alexandru-mot/SAVITAR-V2-PCB/models/gearmotor_module_assembly_inline_rev3_mirror.step

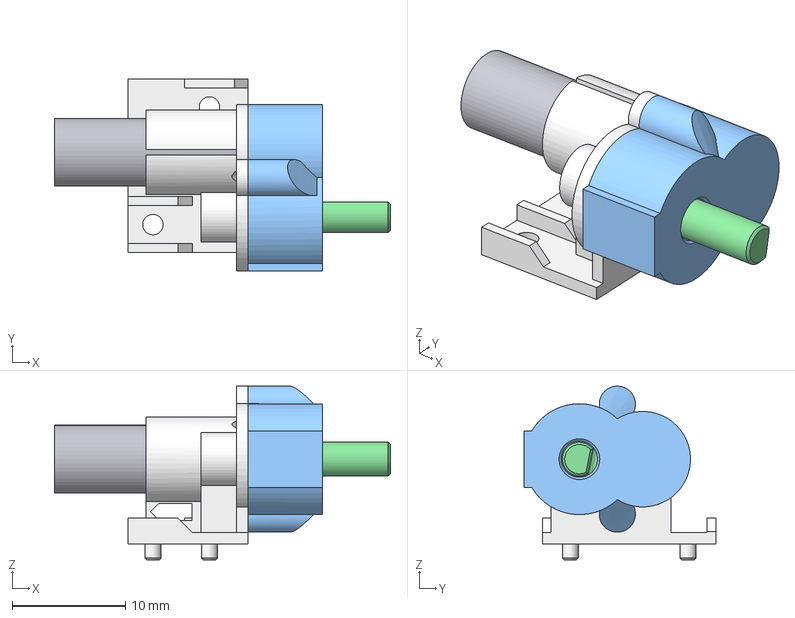
[picture p1: CAD file, 2026-11-13]
models/gearmotor_module_assembly_inline_rev3_mirror.step
29.7 x 17.0 x 15.4 mm
housing_base
housing_cover
motor
pinion_12T
gear_16T
