alexandru-mot/SAVITAR-V2-PCB/sensor.step

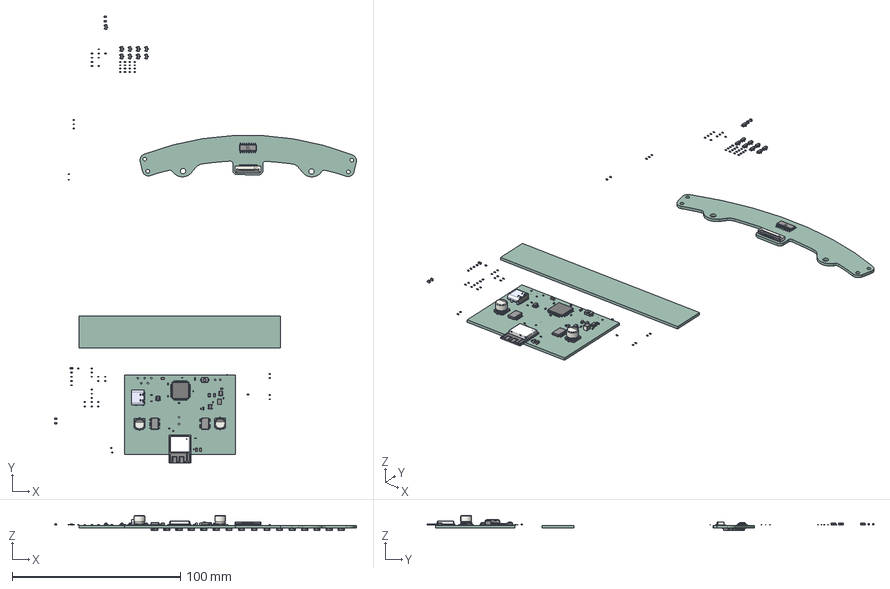
[picture p2: CAD file, 2026-10-30]
sensor.step
179.7 x 265.7 x 8.93 mm
R_0402_1005Metric x 54
LED_0603_1608Metric x 4
C_0402_1005Metric x 19
SOT-23 x 9
C_0603_1608Metric x 3
SOT-23-5
SW_SPST_TS-1088-xR020
C_0805_2012Metric x 4
SOT-23-6
TQFP-64_10x10mm_P0.5mm
FPC-SMD_22P-P0.50_FPC-05F-22PH20
CP_Elec_6.3x5.8 x 2
ESP32-C3-MINI-1-N4
TYPE-C-31-M-12
PinsArrayLR x 3
LED_0805_2012Metric
L_1210_3225Metric
SOT109-1 lower body
SOT109-1 upper body
SOT109-1 Lead
L_0603_1608Metric
OnSemi_CASE100CY x 16
SAVITAR_V2_PCB_1
SAVITAR_V2_PCB_2
SAVITAR_V2_PCB_3
