alexandru-mot/SAVITAR-V2-PCB/models/JS2622.stp

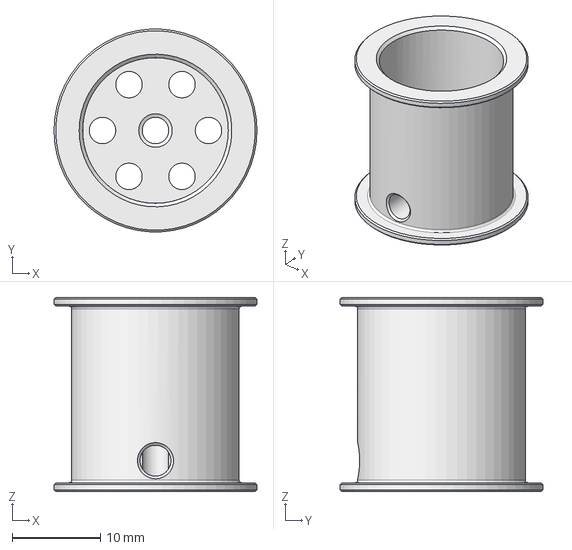
[picture p3: CAD file, 2026-11-13]
models/JS2622.stp
23.0 x 23.0 x 22.0 mm
