alexandru-mot/SAVITAR-V2-PCB/models/Roata_JS2622.stp

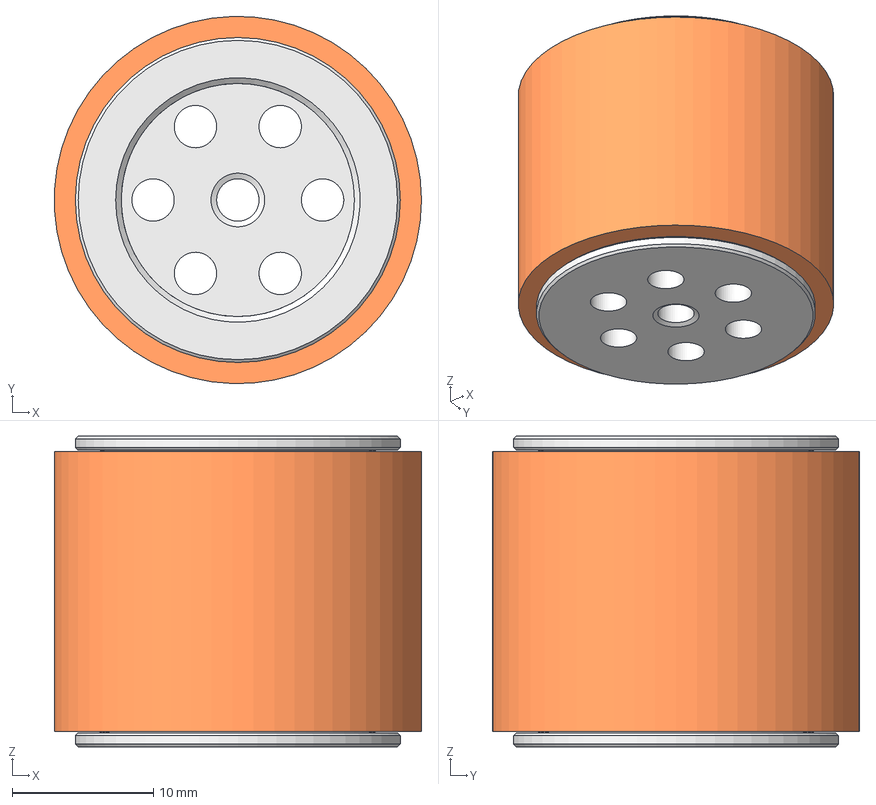
[picture p4: CAD file, 2026-11-13]
models/Roata_JS2622.stp
26.0 x 26.0 x 22.0 mm
JS2622
Goma JS2622
