alexandru-mot/SAVITAR-V2-PCB/models/FSUSB42MUX.stp

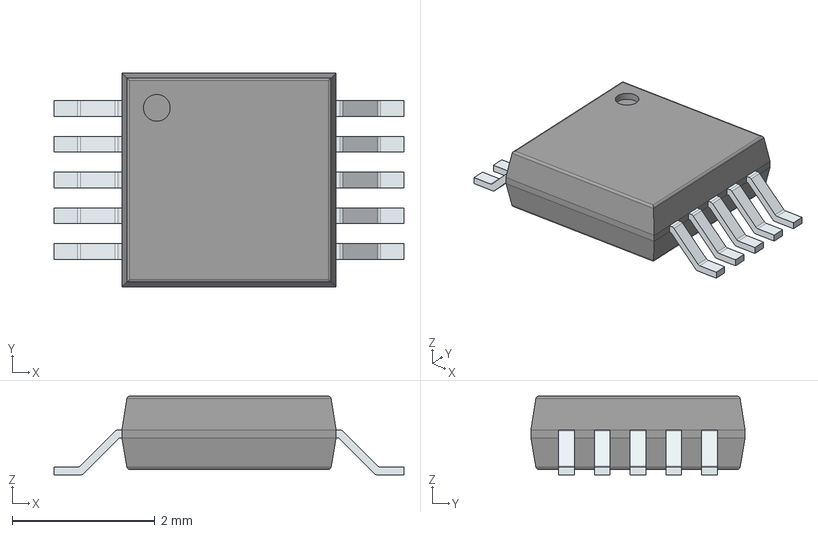
[picture p5: CAD file, 2026-05-28]
models/FSUSB42MUX.stp
4.90 x 3.00 x 1.10 mm
PinsArrayLR
