alexandru-mot/SAVITAR-V2-PCB/models/SSSS811101.step

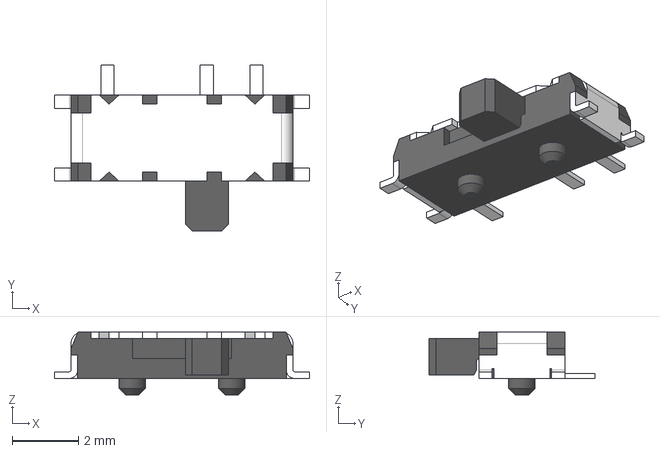
[picture p6: CAD file, 2026-05-28]
models/SSSS811101.step
7.70 x 5.00 x 1.90 mm
