alexandru-mot/SAVITAR-V2-PCB/models/TYPE-C-31-M-12.step

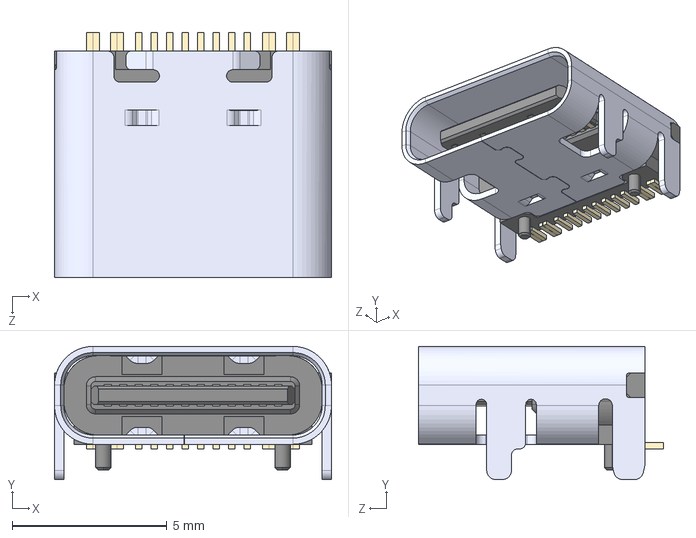
[picture p7: CAD file, 2026-05-28]
models/TYPE-C-31-M-12.step
8.94 x 4.30 x 7.90 mm
