alexandru-mot/SAVITAR-V2-PCB/models/FH34SRJ-8S-0.5SH_50_.step

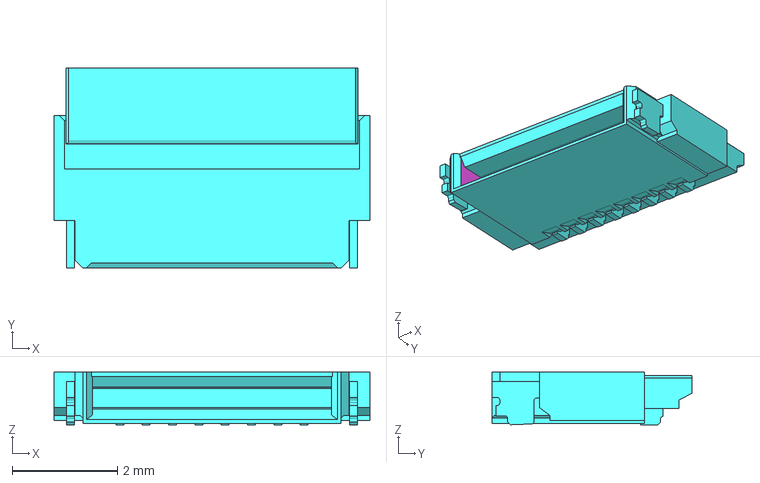
[picture p8: CAD file, 2026-05-23]
models/FH34SRJ-8S-0.5SH_50_.step
6.00 x 3.80 x 1.00 mm
