alexandru-mot/SAVITAR-V2-PCB/models/ESP32-C3-MINI-1-N4.stp

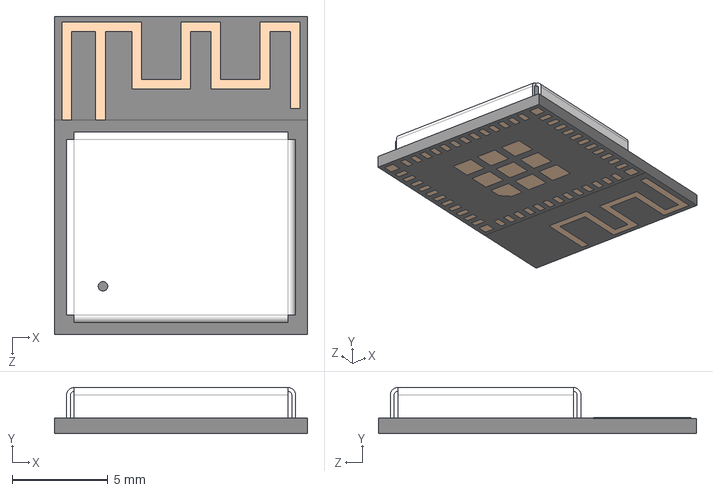
[picture p9: CAD file, 2026-05-23]
models/ESP32-C3-MINI-1-N4.stp
13.2 x 2.40 x 16.6 mm
