alexandru-mot/SAVITAR-V2-PCB/models/INA240A1DR.stp

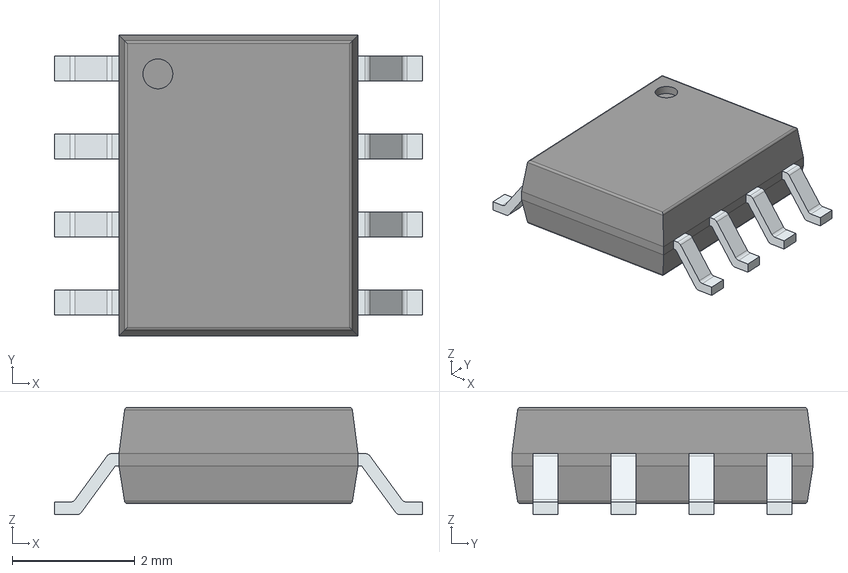
[picture p10: CAD file, 2026-05-20]
models/INA240A1DR.stp
6.00 x 4.91 x 1.75 mm
PinsArrayLR
