alexandru-mot/SAVITAR-V2-PCB/models/DRV8874PWPR.stp

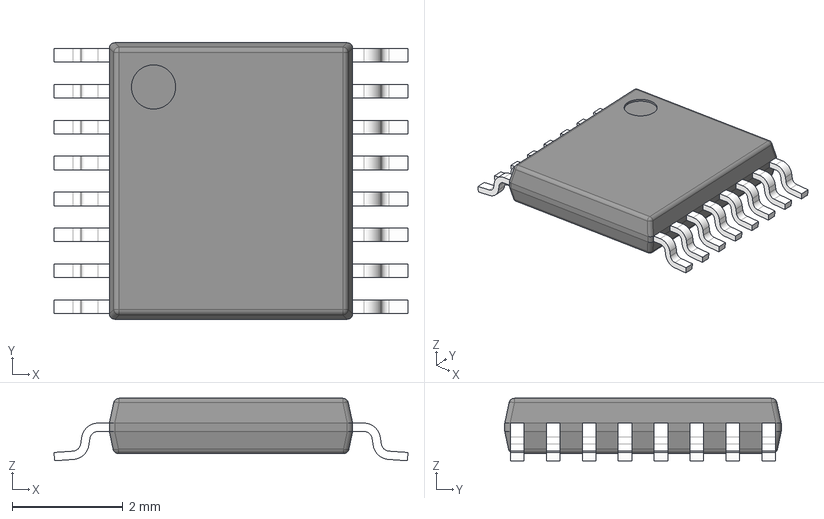
[picture p11: CAD file, 2026-05-17]
models/DRV8874PWPR.stp
6.40 x 5.00 x 1.13 mm
BODY-TSSOP
LEAD-TSSOP x 16
PIN1
DAP
