alexandru-mot/SAVITAR-V2-PCB/models/DEV-15583.step

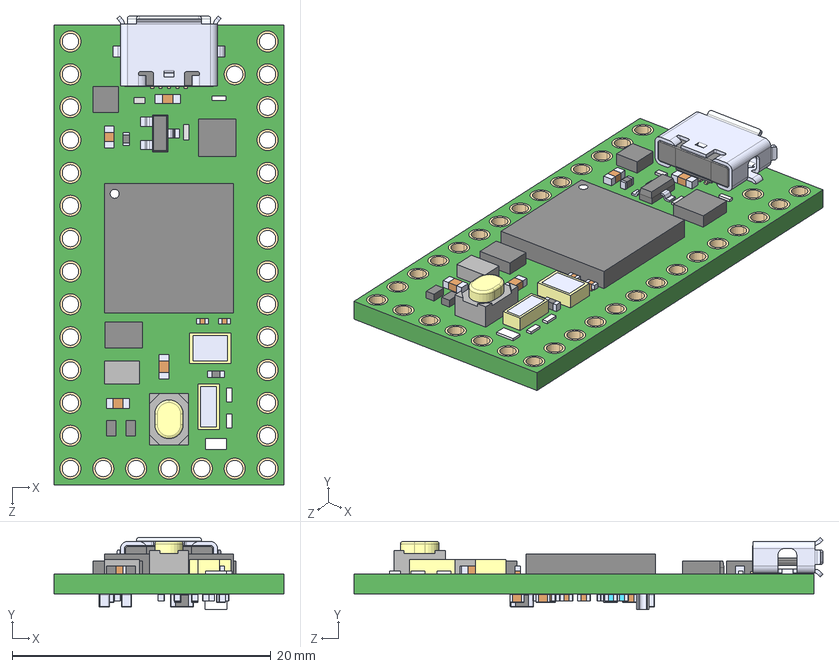
[picture p12: CAD file, 2026-05-17]
models/DEV-15583.step
17.8 x 5.58 x 36.3 mm
DEV-15583 board
C5-C18 (0.55mm)
C20-C24 (0.65)
R1-R3 (0.4inch)_1269AS-H-3R3M=P2
L1^DEV-15583 ASS
C x 2
C2
