alexandru-mot/SAVITAR-V2-PCB/models/MT2492.stp

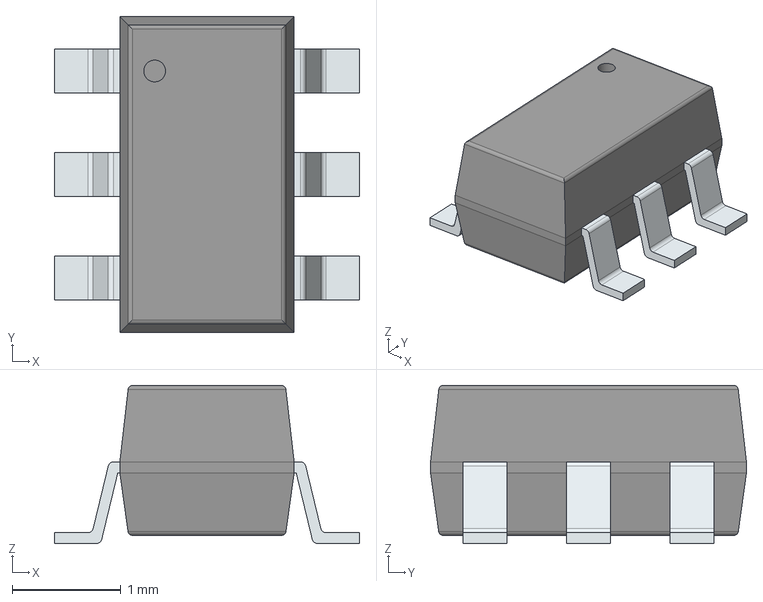
[picture p13: CAD file, 2026-05-14]
models/MT2492.stp
2.80 x 2.90 x 1.45 mm
PinsArrayLR
