alexandru-mot/SAVITAR-V2-PCB/models/74HC238D,653.stp

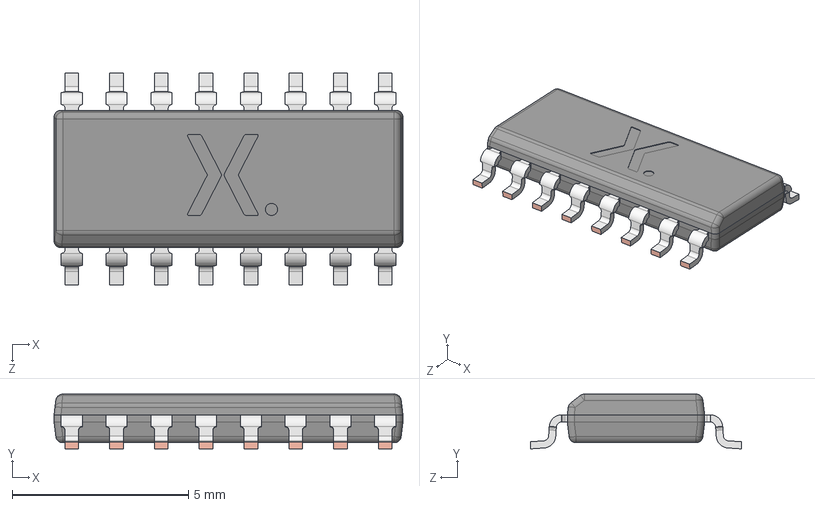
[picture p14: CAD file, 2026-05-12]
models/74HC238D,653.stp
9.90 x 1.56 x 6.00 mm
SOT109-1 lower body
SOT109-1 upper body
SOT109-1 Lead
