alexandru-mot/SAVITAR-V2-PCB/models/CD4051BM_TR.stp

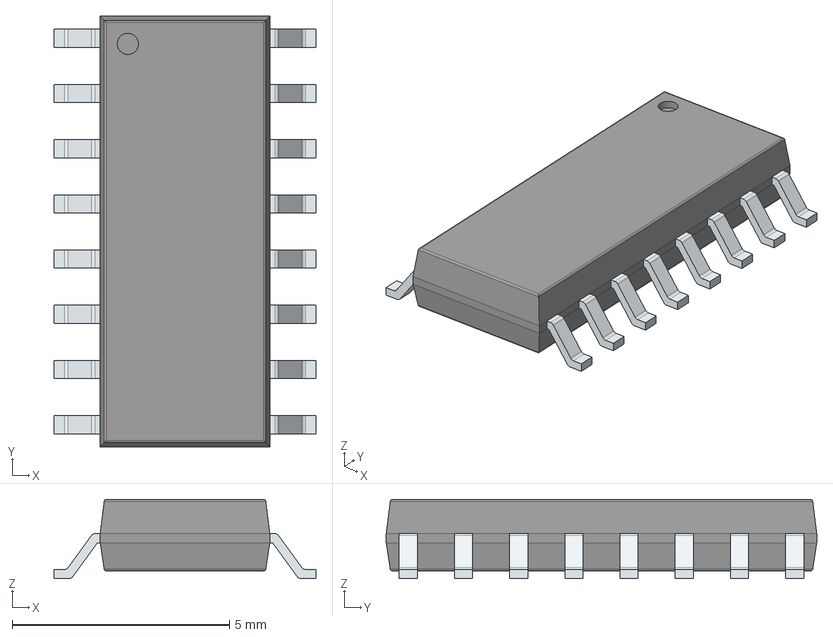
[picture p15: CAD file, 2026-05-10]
models/CD4051BM_TR.stp
6.03 x 9.90 x 1.82 mm
PinsArrayLR
