alexandru-mot/SAVITAR-V2-PCB/models/FH34SRJ-12S-0.5SH_50_.stp

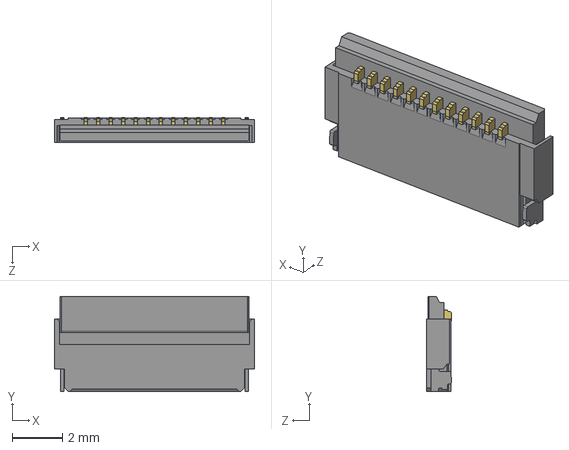
[picture p16: CAD file, 2026-05-10]
models/FH34SRJ-12S-0.5SH_50_.stp
8.00 x 3.80 x 1.00 mm
