alexandru-mot/SAVITAR-V2-PCB/(list of files, cad)

Other CAD files:
models/gearmotor_module_assembly_inline_rev3.step
models/FH34SRJ-8S-0.5SH_99_.stp
models/ESP32-C3-MINI-1-H4X.stp
models/52271-0869.stp
models/FH34SRJ-8S-0.5SH_50_.stp
models/TBD62083AFNG_Z,EL_.stp
models/gearmotor_module_assembly_inline_rev2.step
models/gearmotor_module_assembly_inline_rev2_mirror.step
