alexandru-mot/SAVITAR-V2-PCB/SAVITAR_V2-SAMD51 ESP32.pdf

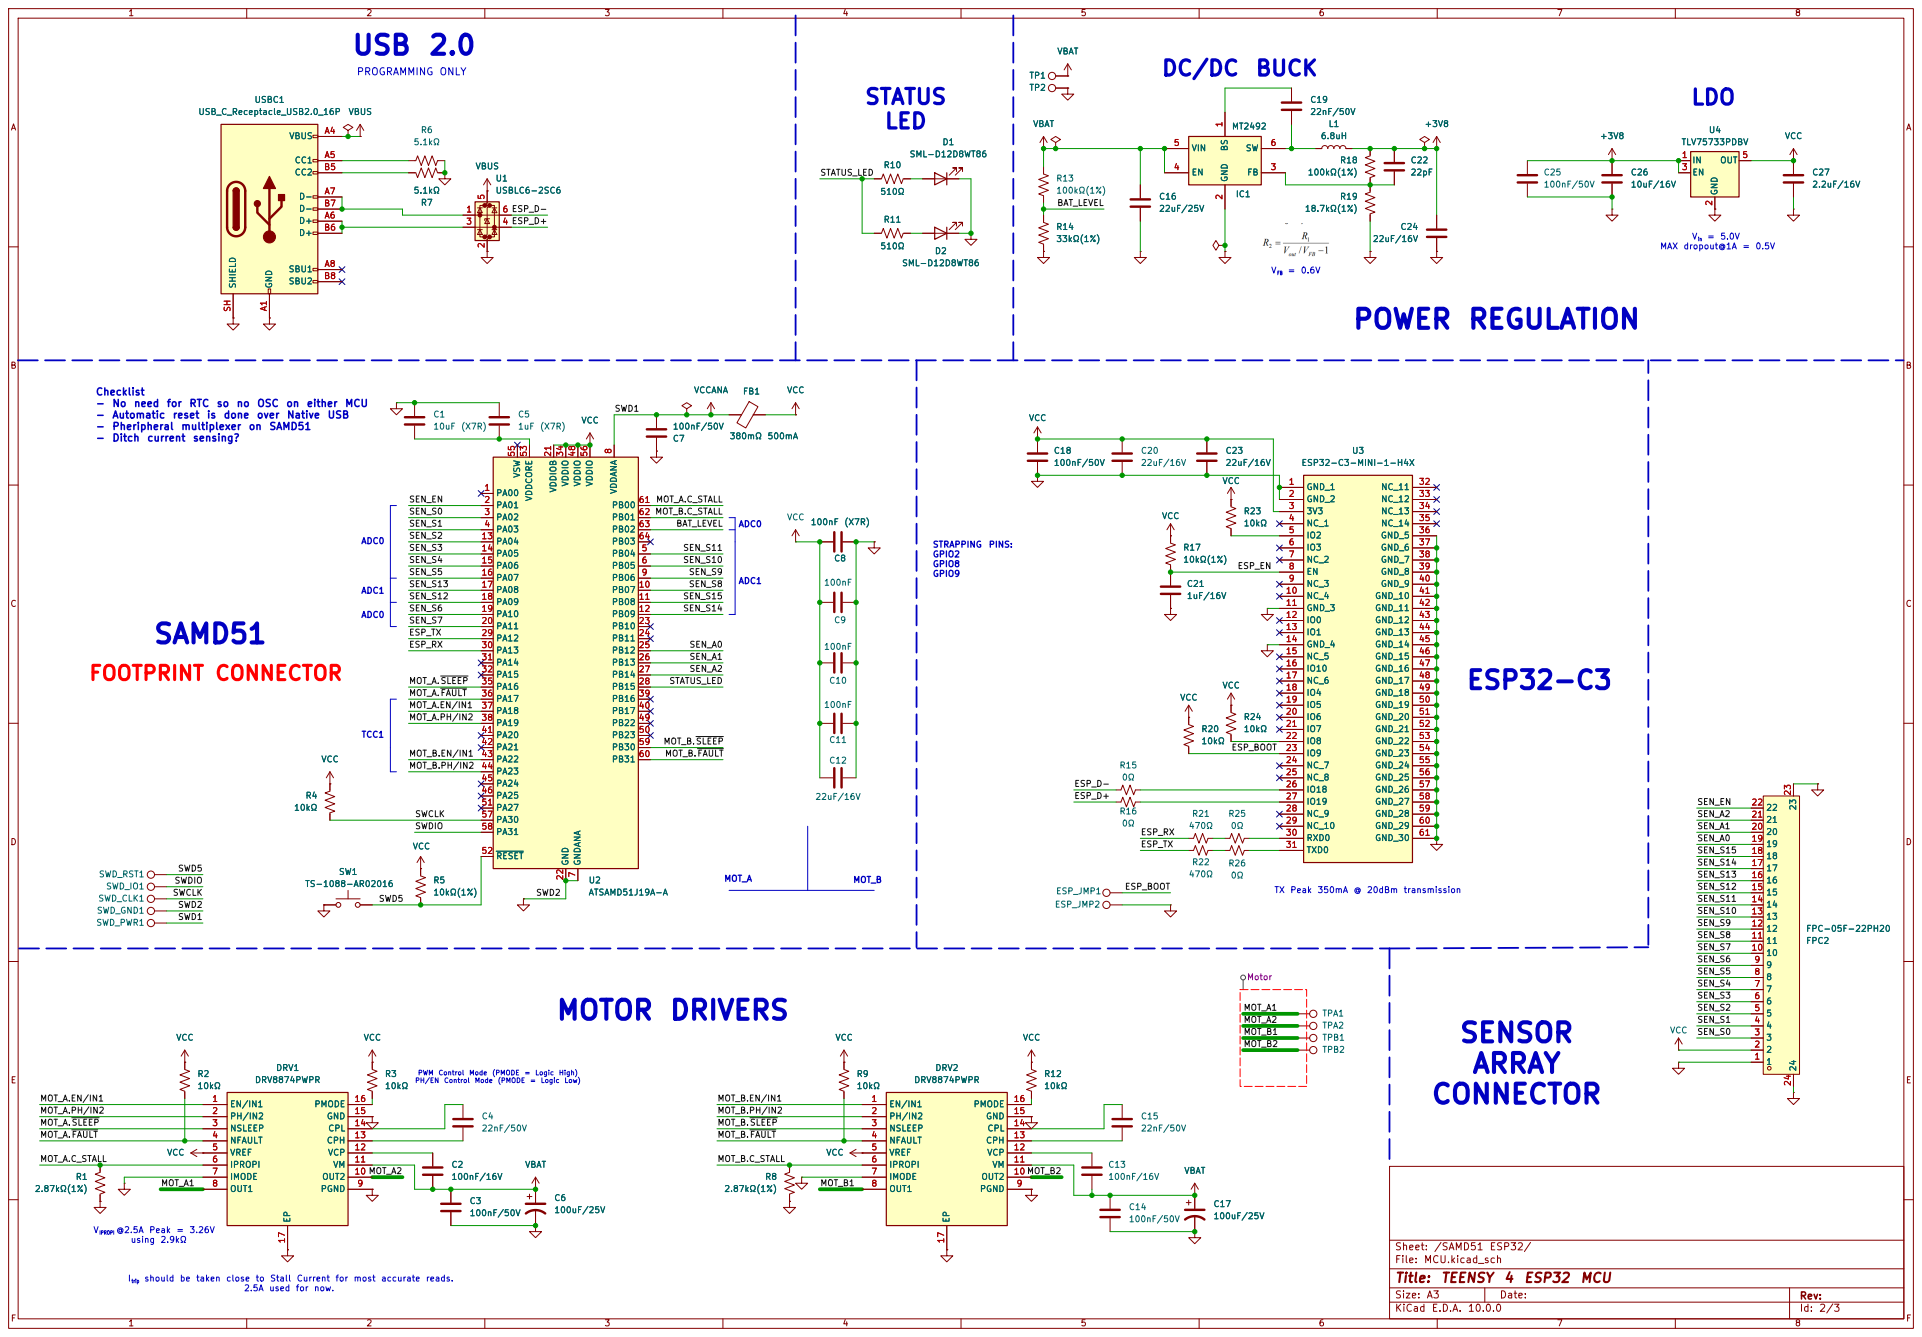
[picture p17: page 1]

V FB = 0.6V Checklist - No need for RTC so no OSC on either MCU - Automatic reset is done over Native USB - Pheripheral multiplexer on SAMD51 - Ditch current sensing?

I trip should be taken close to Stall Current for most accurate reads. 2.5A used for now. FOOTPRINT CONNECTOR

Size: A3 | Rev: | F Date:
KiCad E.D.A. 10.0.0 | Id: 2/3
