alexandru-mot/SAVITAR-V2-PCB/SAVITAR_V2.pdf

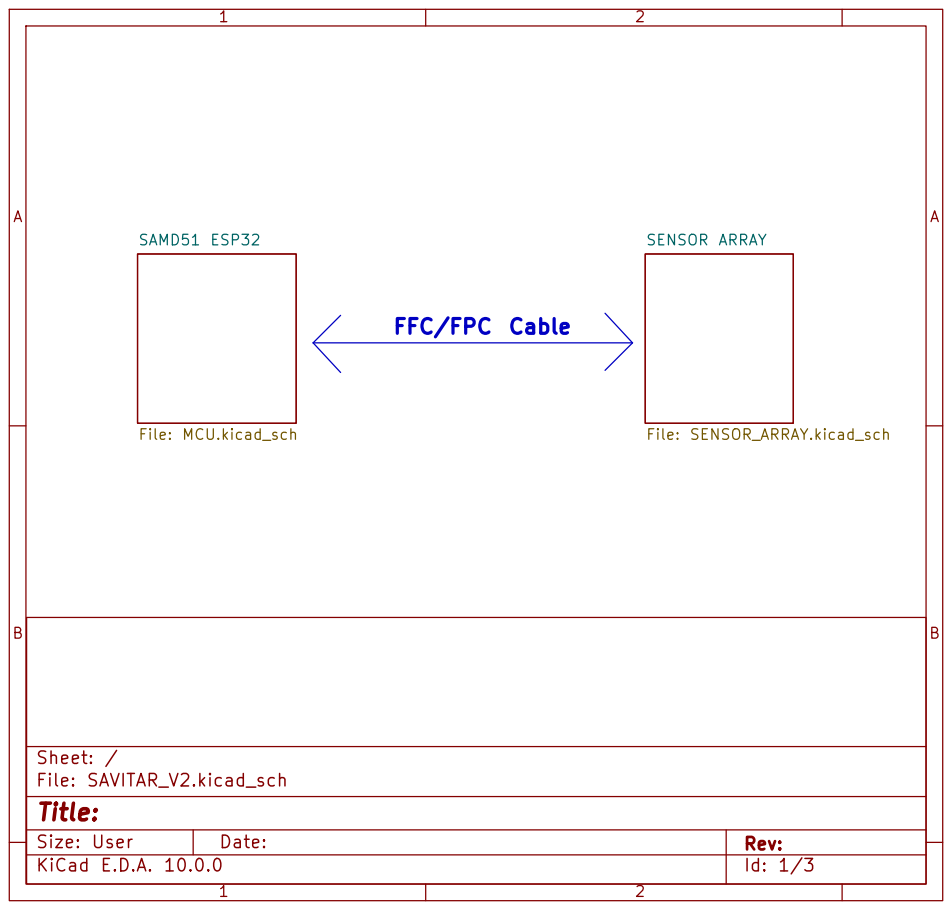
[picture p18: page 1]

File: SENSOR_ARRAY.kicad_sch FFC/FPC Cable

Size: User | Rev:
KiCad E.D.A. 10.0.0 | Id: 1/3

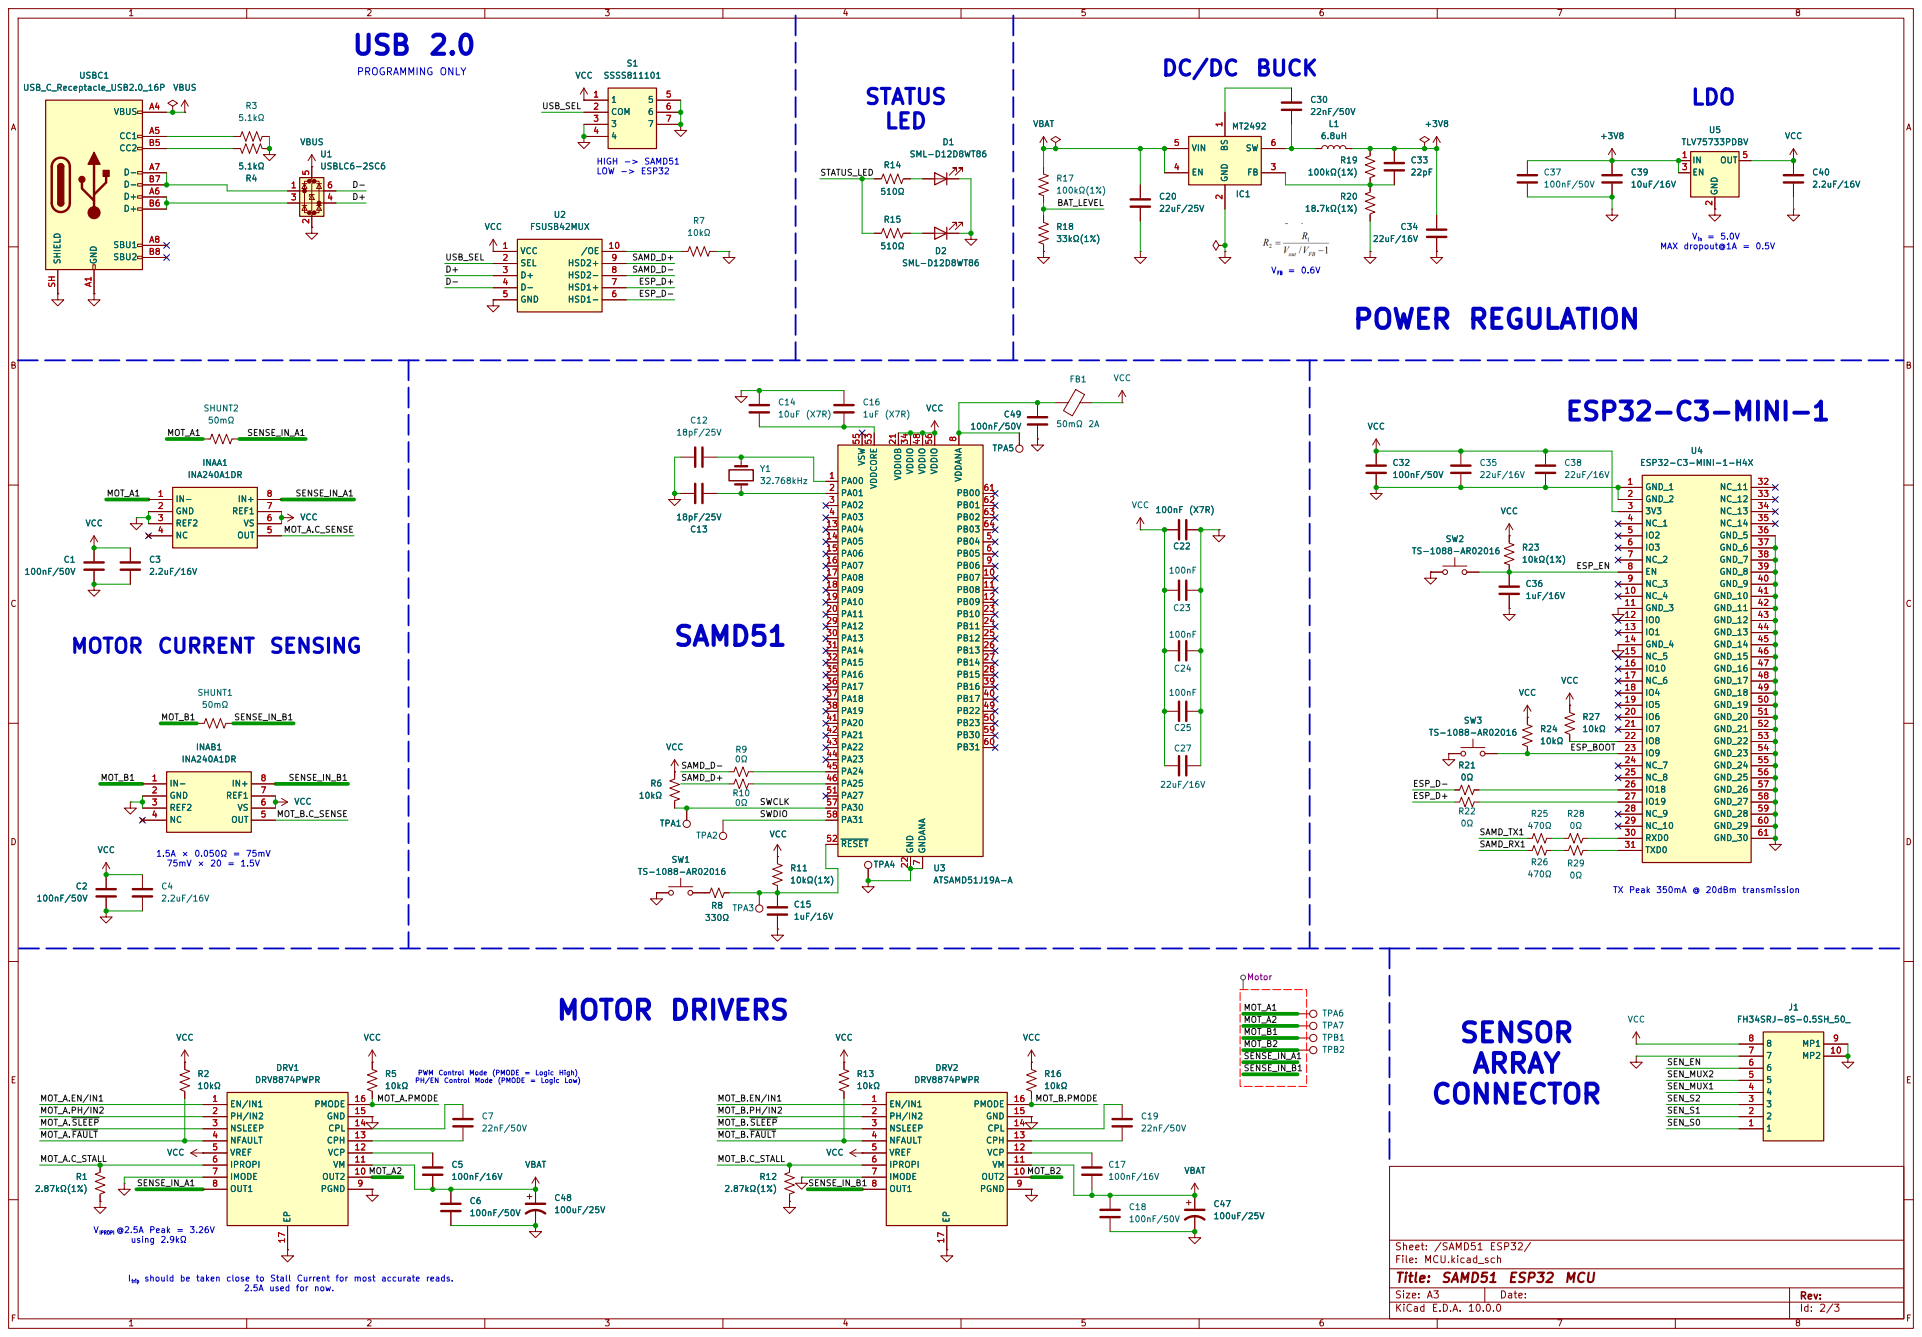
[picture p19: page 2]

PROGRAMMING ONLY MOTOR CURRENT SENSING

IO3 6 NC_2 7 | 37 GND_7
EN 8 NC_3 9 NC_4 10 GND_3 11 | 38 GND_8 38 GND_8 39 GND_9 39 GND_9

IO0 12 | 43 GND_13
IO1 13 GND_4 14 NC_5 15 | 45 GND_15

IO10 16 NC_6 17 | 47 GND_17

IO4 18 | 49 GND_19
IO5 19 | 50 GND_20
IO6 20 | 51 GND_21

IO9 23 NC_7 24 NC_8 25 | 55 GND_25

IO18 26 IO18 26 IO19 27 NC_9 28 NC_10 29 RXD0 30 IO19 27 NC_9 28 NC_10 29 RXD0 30 | 57 GND_27

Size: A3 | Rev: | F Date:
KiCad E.D.A. 10.0.0 | Id: 2/3

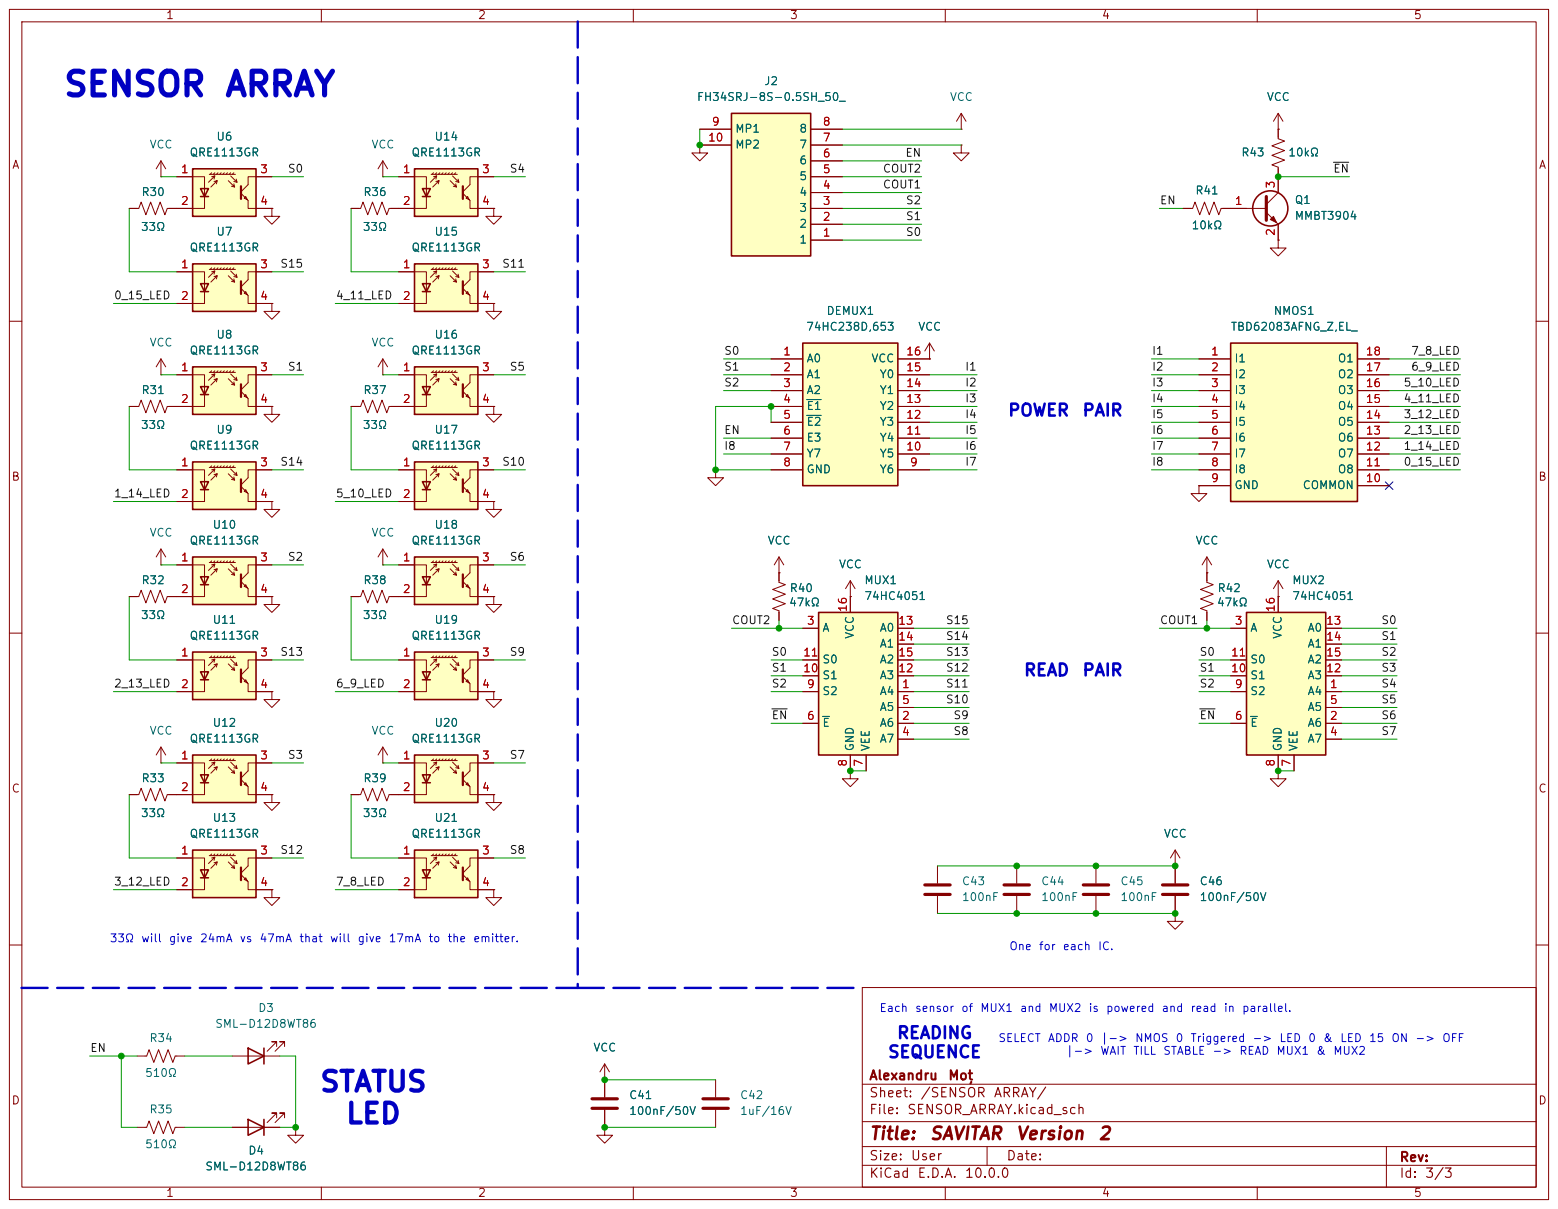
[picture p20: page 3]

33Ω will give 24mA vs 47mA that will give 17mA to the emitter. SENSOR ARRAY

One for each IC.

Each sensor of MUX1 and MUX2 is powered and read in parallel.
READING
SEQUENCE
Alexandru Moț
Sheet: /SENSOR ARRAY/
File: SENSOR_ARRAY.kicad_sch
Title: SAVITAR Version 2

SELECT ADDR 0 |-> NMOS 0 Triggered -> LED 0 & LED 15 ON -> OFF |-> WAIT TILL STABLE -> READ MUX1 & MUX2

Size: User | Rev:
KiCad E.D.A. 10.0.0 | Id: 3/3
