alexandru-mot/SAVITAR-V2-PCB/Output/SAVITAR_V2.pdf

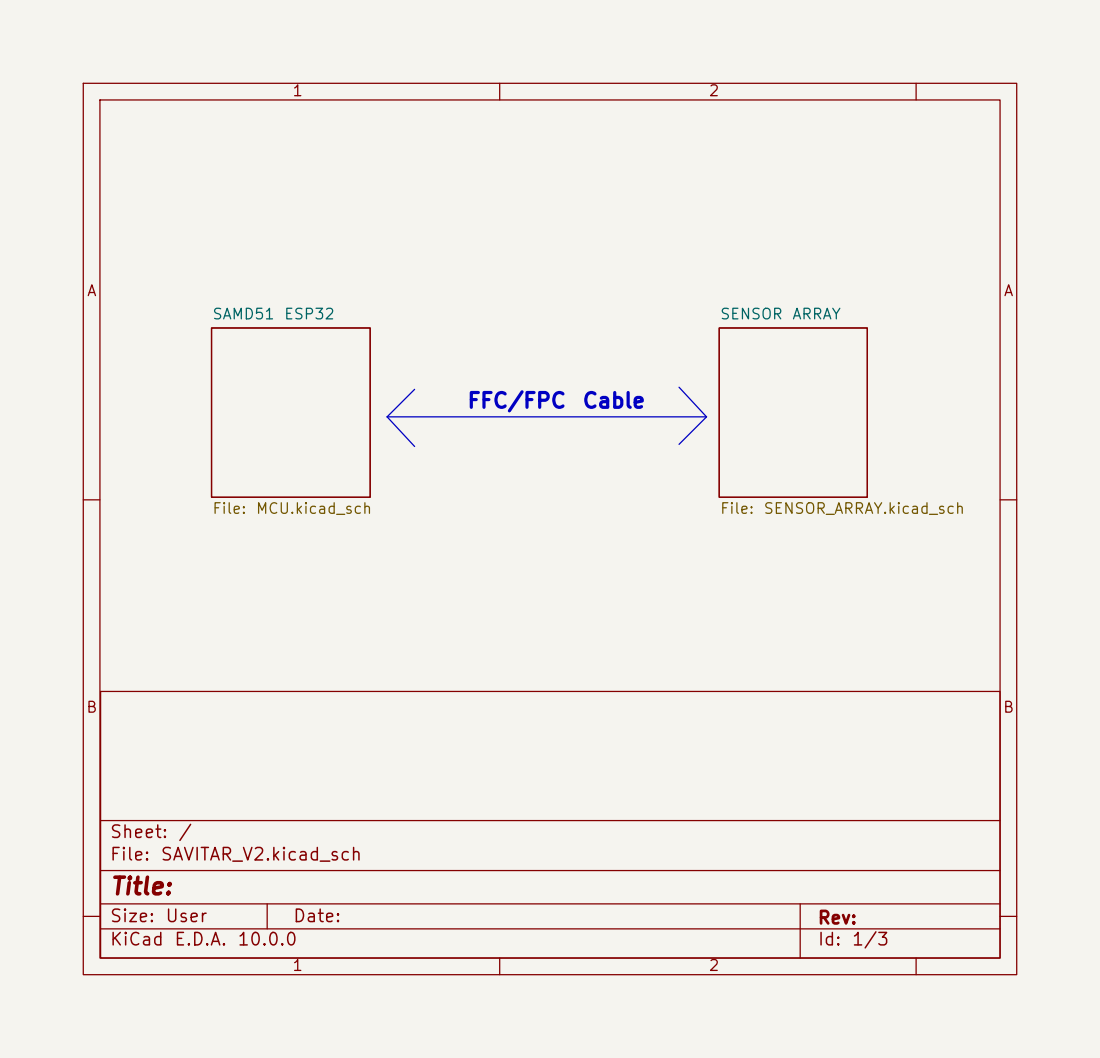
[picture p21: page 1]

File: SENSOR_ARRAY.kicad_sch FFC/FPC Cable

Size: User | Rev:
KiCad E.D.A. 10.0.0 | Id: 1/3

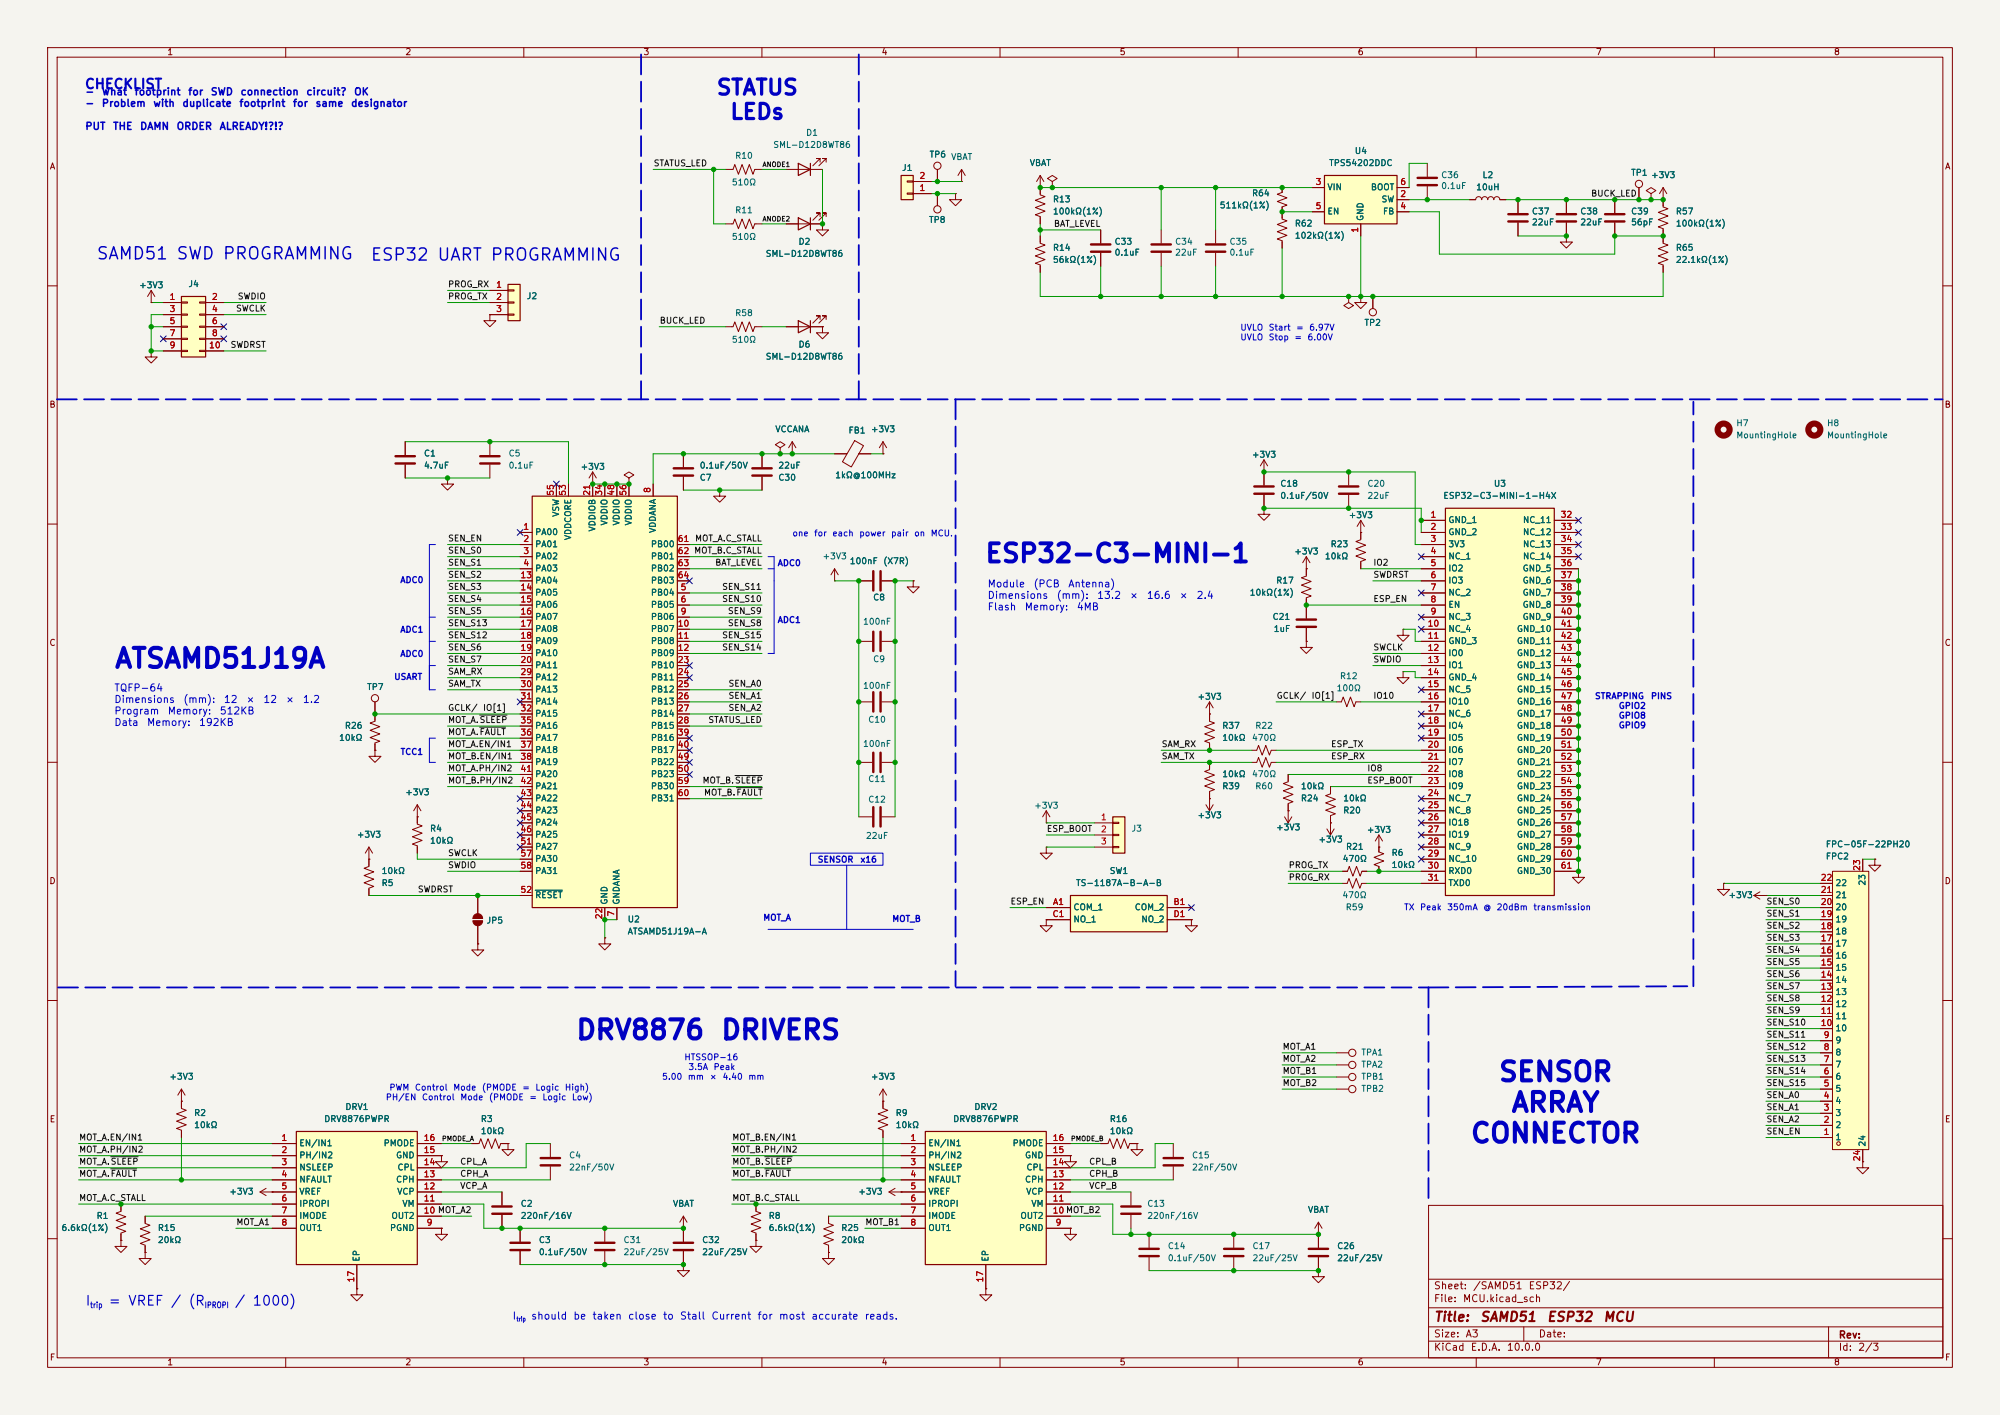
[picture p22: page 2]

PUT THE DAMN ORDER ALREADY!?!?

PROG_RX
PROG_TX
one for each power pair on MCU. MOT_B

UVLO Start = 6.97V UVLO Stop = 6.00V USART ATSAMD51J19A

TX Peak 350mA @ 20dBm transmission Module (PCB Antenna)
Dimensions (mm): 13.2 × 16.6 × 2.4
Flash Memory: 4MB

TQFP-64
Dimensions (mm): 12 × 12 × 1.2 Program Memory: 512KB

I trip should be taken close to Stall Current for most accurate reads. PWM Control Mode (PMODE = Logic High)
PH/EN Control Mode (PMODE = Logic Low)

Size: A3 | Rev: | F Date:
KiCad E.D.A. 10.0.0 | Id: 2/3

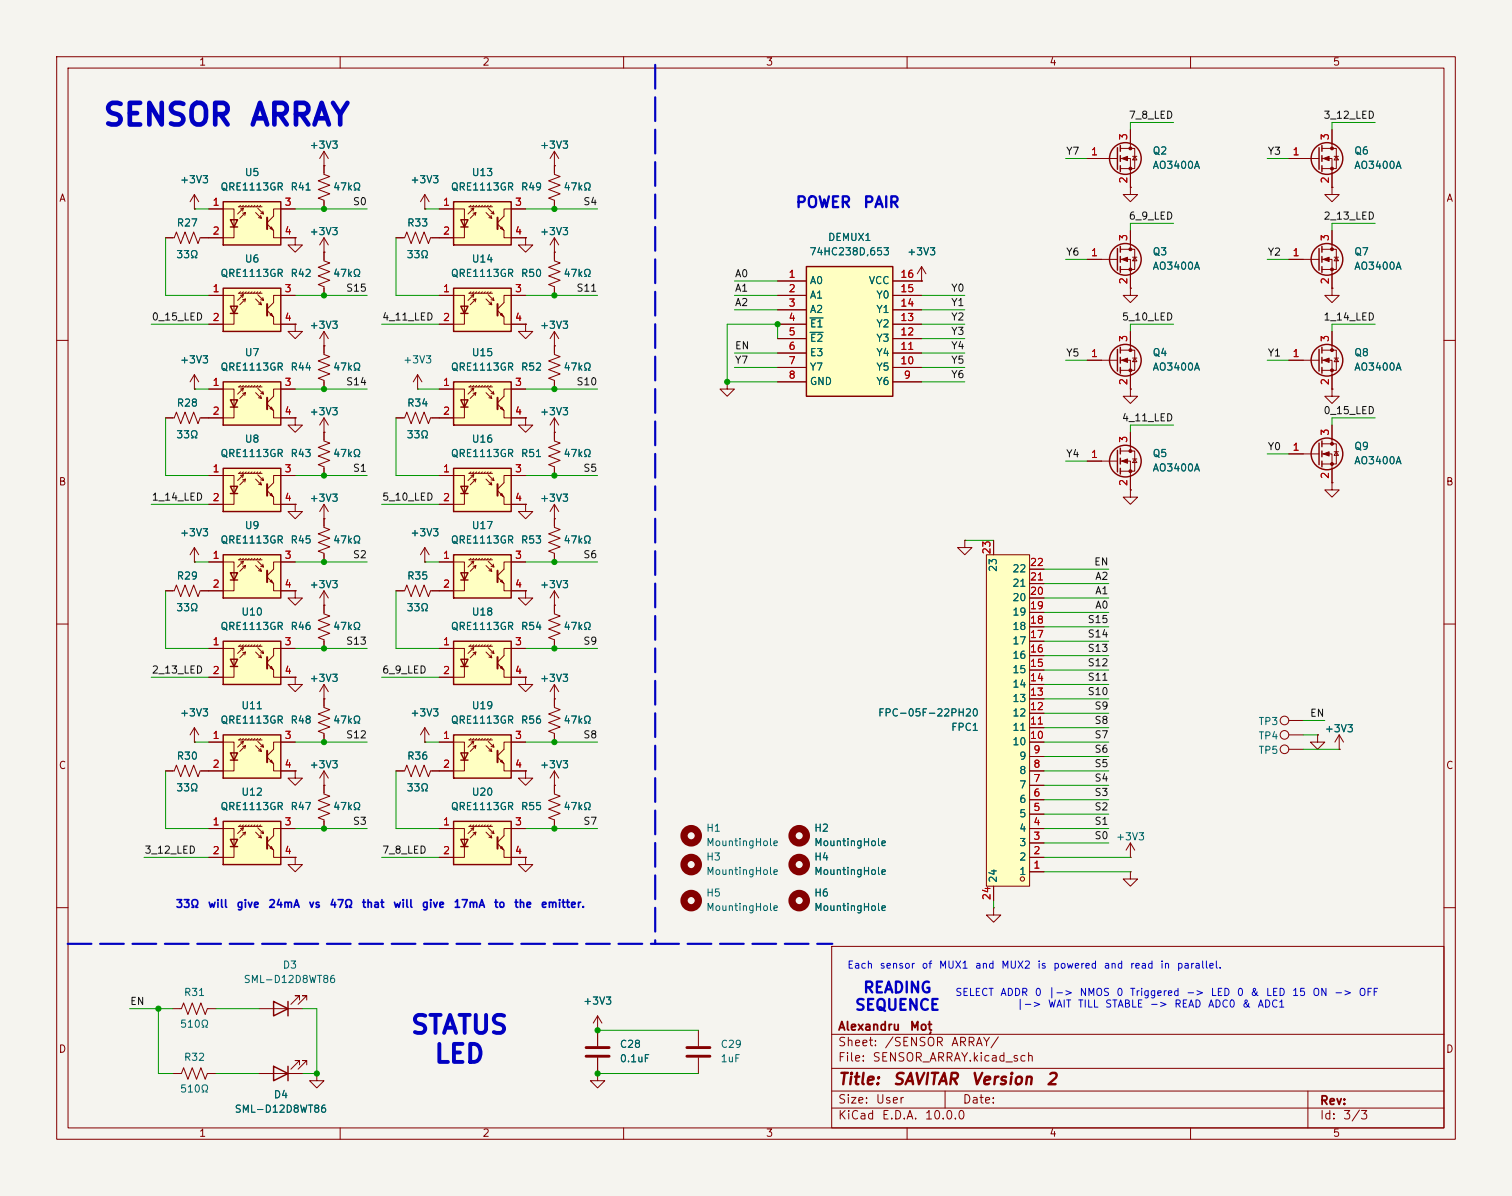
[picture p23: page 3]

Each sensor of MUX1 and MUX2 is powered and read in parallel.

SELECT ADDR 0 |-> NMOS 0 Triggered -> LED 0 & LED 15 ON -> OFF |-> WAIT TILL STABLE -> READ ADC0 & ADC1 READING
SEQUENCE

Size: User | Rev:
KiCad E.D.A. 10.0.0 | Id: 3/3
