alexandru-mot/SAVITAR-V2-PCB/SAVITAR_V2.kicad_pcb

## KiCad design SAVITAR_V2.kicad_pcb (2026-11-13)

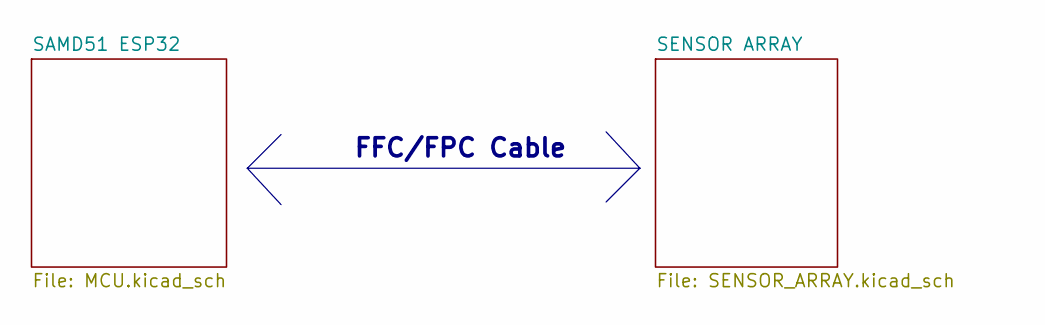
[picture p24: schematic SAVITAR_V2.kicad_sch]

Notes on the sheet:
FFC/FPC Cable

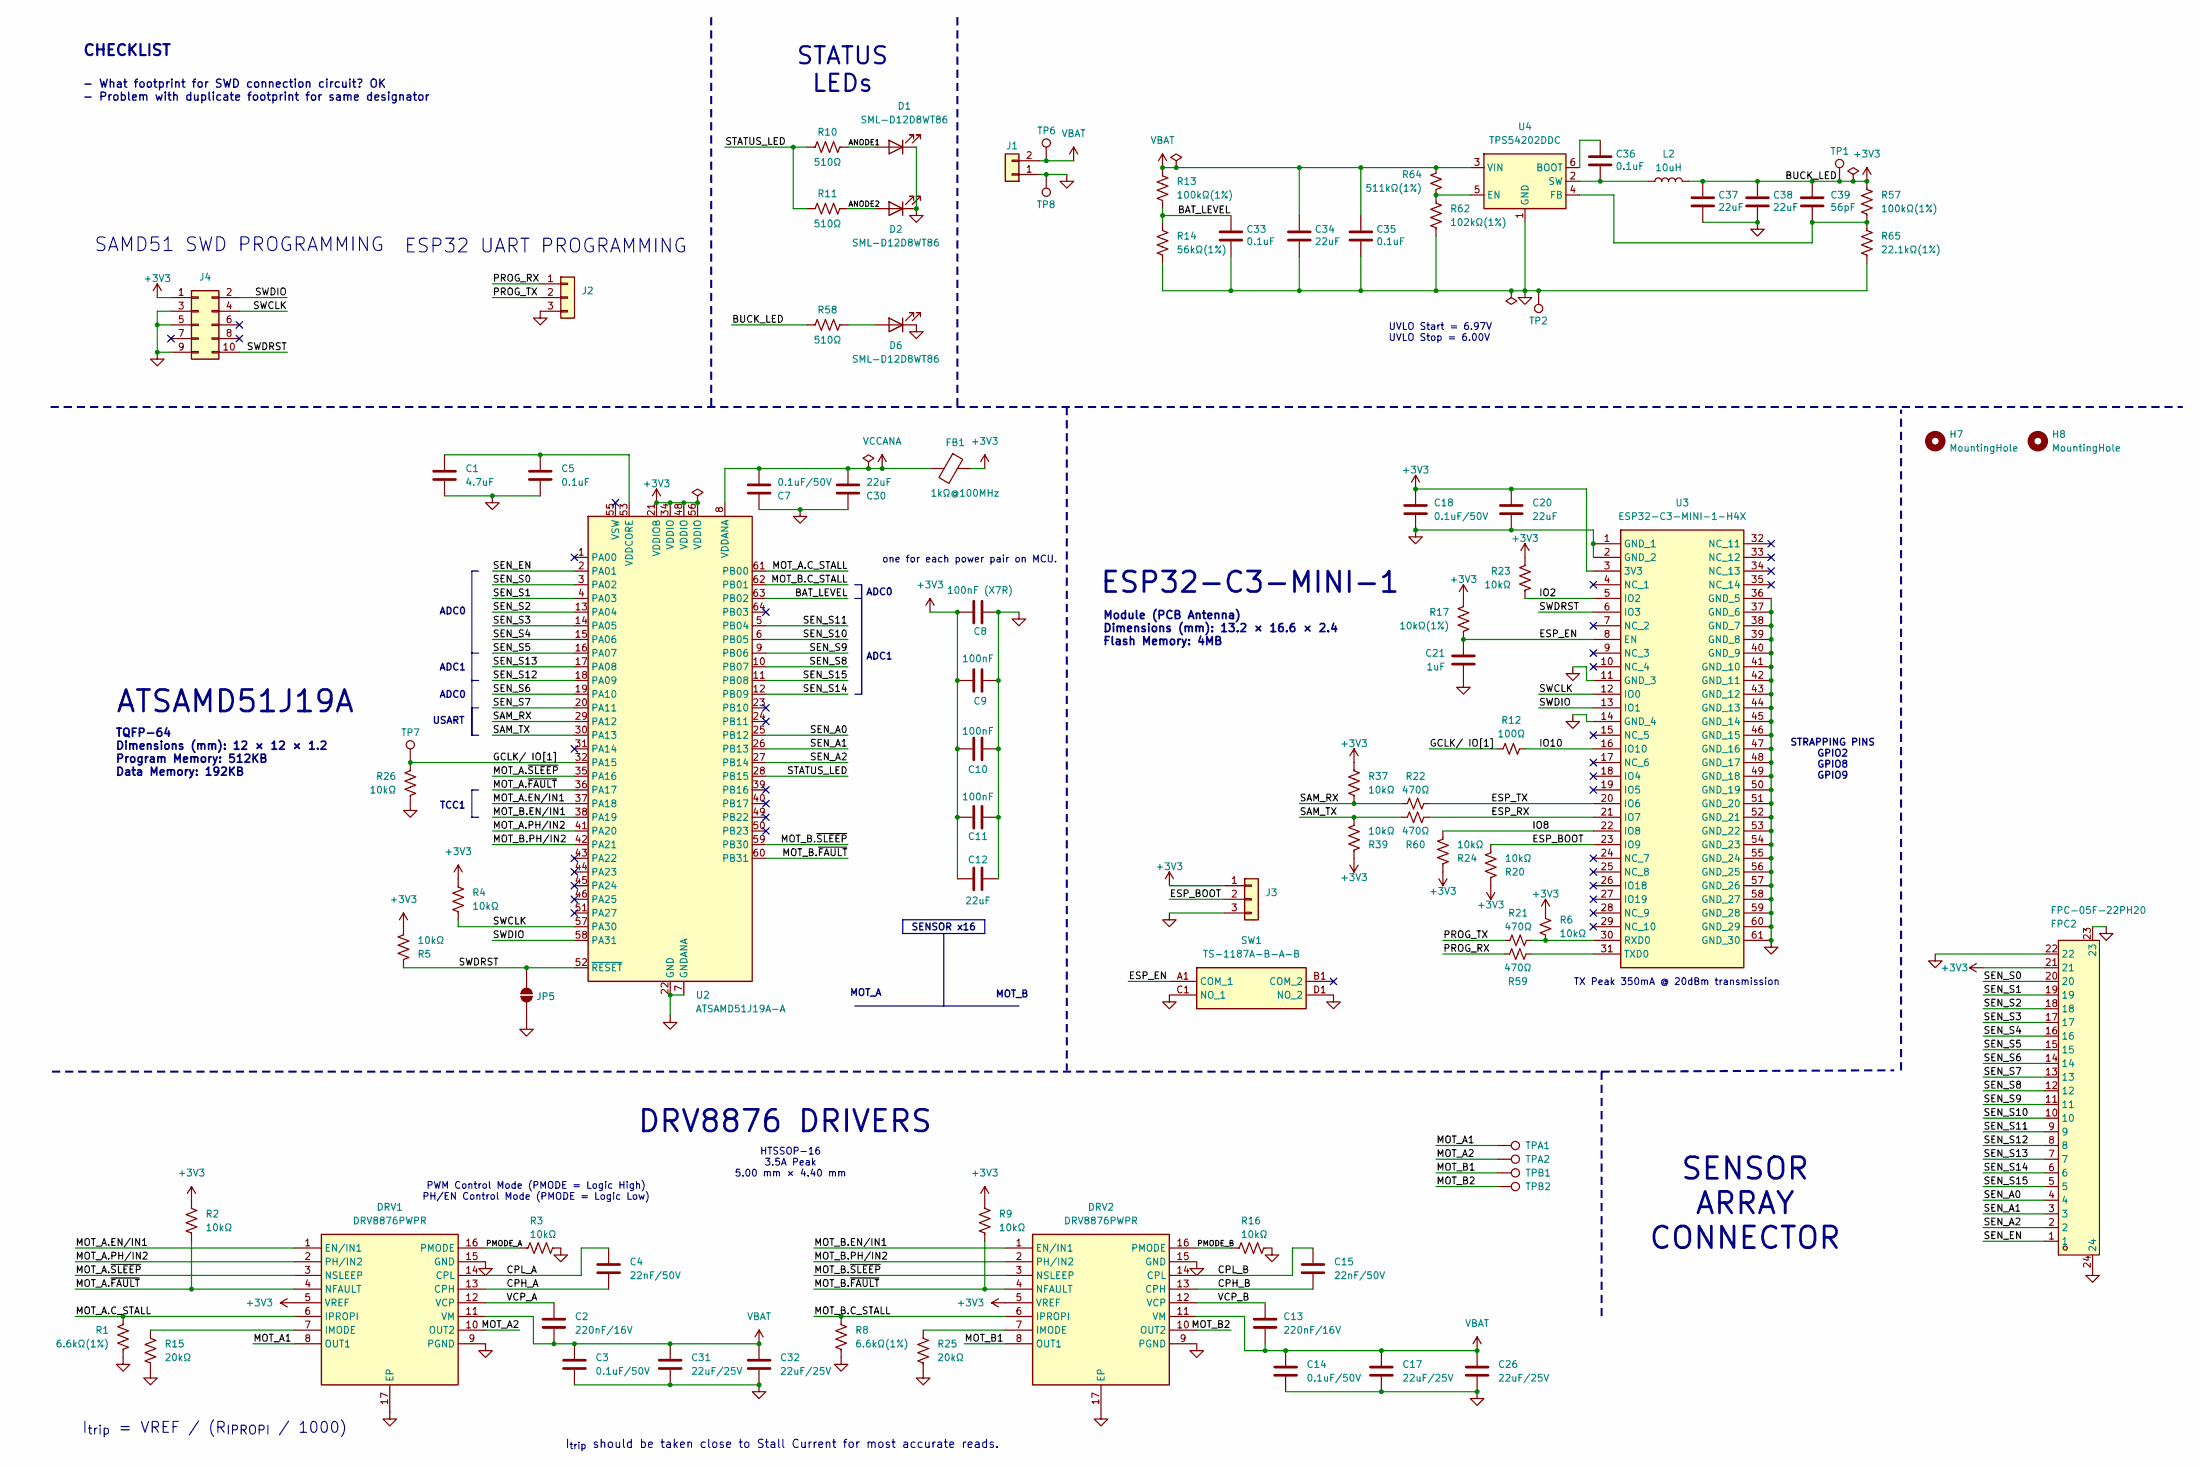
[picture p25: schematic MCU.kicad_sch, SAMD51 ESP32 MCU]

Parts:
C1: 4.7uF; C_0603_1608Metric_Pad1.08x0.95mm_HandSolder
C2, C13: 220nF/16V; C_0402_1005Metric_Pad0.74x0.62mm_HandSolder
C3, C7, C14, C18: 0.1uF/50V; C_0402_1005Metric_Pad0.74x0.62mm_HandSolder
C4, C15: 22nF/50V; C_0402_1005Metric_Pad0.74x0.62mm_HandSolder
C5, C33, C35, C36: 0.1uF; C_0402_1005Metric_Pad0.74x0.62mm_HandSolder
C8: 100nF (X7R); C_0402_1005Metric_Pad0.74x0.62mm_HandSolder
C9, C10, C11: 100nF; C_0402_1005Metric_Pad0.74x0.62mm_HandSolder
C12, C20, C30, C34, C37, C38: 22uF; C_0805_2012Metric_Pad1.18x1.45mm_HandSolder
C17, C26, C31, C32: 22uF/25V; C_0805_2012Metric_Pad1.18x1.45mm_HandSolder
C21: 1uF; C_0402_1005Metric_Pad0.74x0.62mm_HandSolder
C39: 56pF; C_0402_1005Metric_Pad0.74x0.62mm_HandSolder
D1, D2, D6: SML-D12D8WT86; LED_0603_1608Metric_Pad1.05x0.95mm_HandSolder
DRV1, DRV2: DRV8876PWPR; SOP65P640X120-17N; Manufacturer_Part_Number DRV8874PWPR; Mouser Part Number 595-DRV8874PWPR
FB1: 1kΩ@100MHz; L_0805_2012Metric
FPC2: FPC-05F-22PH20; FPC-SMD_22P-P0.50_FPC-05F-22PH20; MPN FPC-05F-22PH20; LCSC Part C2856804
H7, H8: MountingHole; MountingHole_3.2mm_M3
J1: Conn_01x02; JST_PH_S2B-PH-K_1x02_P2.00mm_Horizontal
J2, J3: Conn_01x03; PinHeader_1x03_P2.54mm_Vertical
J4: Conn_02x05_Odd_Even; PinHeader_2x05_P1.27mm_Vertical_SMD
JP5: SolderJumper_2_Open; SolderJumper-2_P1.3mm_Open_RoundedPad1.0x1.5mm
L2: 10uH; L_APV_ANR3015; LCSC Part # C19634061
R1, R8: 6.6kΩ(1%); R_0402_1005Metric_Pad0.72x0.64mm_HandSolder
R2, R3, R4, R5, R6, R9, R16, R20, R23, R24, R26, R37, R39: 10kΩ; R_0402_1005Metric_Pad0.72x0.64mm_HandSolder
R10, R11, R58: 510Ω; R_0402_1005Metric_Pad0.72x0.64mm_HandSolder
R12: 100Ω; R_0402_1005Metric_Pad0.72x0.64mm_HandSolder
R13, R57: 100kΩ(1%); R_0402_1005Metric_Pad0.72x0.64mm_HandSolder
R14: 56kΩ(1%); R_0402_1005Metric_Pad0.72x0.64mm_HandSolder
R15, R25: 20kΩ; R_0402_1005Metric_Pad0.72x0.64mm_HandSolder
R17: 10kΩ(1%); R_0402_1005Metric_Pad0.72x0.64mm_HandSolder
R21, R22, R59, R60: 470Ω; R_0402_1005Metric_Pad0.72x0.64mm_HandSolder
R62: 102kΩ(1%); R_0402_1005Metric_Pad0.72x0.64mm_HandSolder
R64: 511kΩ(1%); R_0402_1005Metric_Pad0.72x0.64mm_HandSolder
R65: 22.1kΩ(1%); R_0402_1005Metric_Pad0.72x0.64mm_HandSolder
SW1: TS-1187A-B-A-B; TS1187ABAB; Manufacturer_Part_Number TS-1187A-B-A-B
TP1, TP2, TP6, TP7, TP8: TestPoint; TestPoint_Pad_D1.5mm
TPA1, TPA2: TestPoint; TestPoint_THTPad_2.0x2.0mm_Drill1.0mm
TPB1, TPB2: TestPoint; TestPoint_THTPad_2.0x2.0mm_Drill1.0mm
U2: ATSAMD51J19A-A; TQFP-64_10x10mm_P0.5mm
U3: ESP32-C3-MINI-1-H4X; ESP32C3MINI1H4X; Manufacturer_Part_Number ESP32-C3-MINI-1-H4X; Mouser Part Number 356-ESP32C3MINI1H4X
U4: TPS54202DDC; SOT-23-6

Connections:
+3V3: C8.2, C9.2, C10.2, C11.2, C12.1, C18.2, C20.1, C37.1, C38.1, C39.1, DRV1.5 (VREF), DRV2.5 (VREF), FB1.1, FPC2.21, J3.1, J4.1, L2.2, R2.1, R4.1, R5.2, R6.1, R9.1, R17.1, R20.1, R23.1, R24.1, R37.1, R39.1, R57.2, R58.1, TP1.1 (1_1), U2.21 (VDDIOB), U2.34 (VDDIO), U2.48 (VDDIO), U2.56 (VDDIO), U3.3 (3V3); also elsewhere on the board
/SAMD51 ESP32/ANODE1: D1.2 (A), R10.2
/SAMD51 ESP32/ANODE2: D2.2 (A), R11.2
/SAMD51 ESP32/BAT_LEVEL: C33.1, R13.1, R14.2, U2.63 (PB02)
/SAMD51 ESP32/CPH_A: C4.1, DRV1.13 (CPH)
/SAMD51 ESP32/CPH_B: C15.1, DRV2.13 (CPH)
/SAMD51 ESP32/CPL_A: C4.2, DRV1.14 (CPL)
/SAMD51 ESP32/CPL_B: C15.2, DRV2.14 (CPL)
/SAMD51 ESP32/ESP_BOOT: J3.2, R20.2, U3.23 (IO9)
/SAMD51 ESP32/ESP_EN: C21.2, R17.2, SW1.A1 (COM_1), U3.8 (EN)
/SAMD51 ESP32/ESP_RX: R60.1, U3.21 (IO7)
/SAMD51 ESP32/ESP_TX: R22.2, U3.20 (IO6)
/SAMD51 ESP32/GCLK/ IO[1]: R12.1, R26.1, TP7.1 (1_1), U2.32 (PA15); also elsewhere on the board
/SAMD51 ESP32/IO2: R23.2, U3.5 (IO2)
/SAMD51 ESP32/IO8: R24.2, U3.22 (IO8)
/SAMD51 ESP32/IO10: R12.2, U3.16 (IO10); also elsewhere on the board
/SAMD51 ESP32/MOT_A1: DRV1.8 (OUT1), TPA1.1 (1_1)
/SAMD51 ESP32/MOT_A2: DRV1.10 (OUT2), TPA2.1 (1_1)
/SAMD51 ESP32/MOT_A.C_STALL: DRV1.6 (IPROPI), R1.1, U2.61 (PB00)
/SAMD51 ESP32/MOT_A.EN/IN1: DRV1.1 (EN/IN1), U2.37 (PA18)
/SAMD51 ESP32/MOT_A.PH/IN2: DRV1.2 (PH/IN2), U2.41 (PA20)
/SAMD51 ESP32/MOT_A.~FAULT: DRV1.4 (NFAULT), R2.2, U2.36 (PA17)
/SAMD51 ESP32/MOT_A.~SLEEP: DRV1.3 (NSLEEP), U2.35 (PA16)
/SAMD51 ESP32/MOT_B1: DRV2.8 (OUT1), TPB1.1 (1_1)
/SAMD51 ESP32/MOT_B2: DRV2.10 (OUT2), TPB2.1 (1_1)
/SAMD51 ESP32/MOT_B.C_STALL: DRV2.6 (IPROPI), R8.1, U2.62 (PB01)
/SAMD51 ESP32/MOT_B.EN/IN1: DRV2.1 (EN/IN1), U2.38 (PA19)
/SAMD51 ESP32/MOT_B.PH/IN2: DRV2.2 (PH/IN2), U2.42 (PA21)
/SAMD51 ESP32/MOT_B.~FAULT: DRV2.4 (NFAULT), R9.2, U2.60 (PB31)
/SAMD51 ESP32/MOT_B.~SLEEP: DRV2.3 (NSLEEP), U2.59 (PB30)
/SAMD51 ESP32/PMODE_A: DRV1.16 (PMODE), R3.2
/SAMD51 ESP32/PMODE_B: DRV2.16 (PMODE), R16.2
/SAMD51 ESP32/PROG_RX: J2.1, R59.2
/SAMD51 ESP32/PROG_TX: J2.2, R21.1
/SAMD51 ESP32/SAM_RX: R22.1, R37.2, U2.29 (PA12)
/SAMD51 ESP32/SAM_TX: R39.2, R60.2, U2.30 (PA13)
/SAMD51 ESP32/SEN_A0: FPC2.4, U2.25 (PB12)
/SAMD51 ESP32/SEN_A1: FPC2.3, U2.26 (PB13)
/SAMD51 ESP32/SEN_A2: FPC2.2, U2.27 (PB14)
/SAMD51 ESP32/SEN_EN: FPC2.1, U2.2 (PA01)
/SAMD51 ESP32/SEN_S0: FPC2.20, U2.3 (PA02)
/SAMD51 ESP32/SEN_S1: FPC2.19, U2.4 (PA03)
/SAMD51 ESP32/SEN_S2: FPC2.18, U2.13 (PA04)
/SAMD51 ESP32/SEN_S3: FPC2.17, U2.14 (PA05)
/SAMD51 ESP32/SEN_S4: FPC2.16, U2.15 (PA06)
/SAMD51 ESP32/SEN_S5: FPC2.15, U2.16 (PA07)
/SAMD51 ESP32/SEN_S6: FPC2.14, U2.19 (PA10)
/SAMD51 ESP32/SEN_S7: FPC2.13, U2.20 (PA11)
/SAMD51 ESP32/SEN_S8: FPC2.12, U2.10 (PB07)
/SAMD51 ESP32/SEN_S9: FPC2.11, U2.9 (PB06)
/SAMD51 ESP32/SEN_S10: FPC2.10, U2.6 (PB05)
/SAMD51 ESP32/SEN_S11: FPC2.9, U2.5 (PB04)
/SAMD51 ESP32/SEN_S12: FPC2.8, U2.18 (PA09)
/SAMD51 ESP32/SEN_S13: FPC2.7, U2.17 (PA08)
/SAMD51 ESP32/SEN_S14: FPC2.6, U2.12 (PB09)
/SAMD51 ESP32/SEN_S15: FPC2.5, U2.11 (PB08)
/SAMD51 ESP32/STATUS_LED: R10.1, R11.1, U2.28 (PB15)
/SAMD51 ESP32/SWCLK: J4.4, R4.2, U2.57 (PA30), U3.12 (IO0)
/SAMD51 ESP32/SWDIO: J4.2, U2.58 (PA31), U3.13 (IO1)
/SAMD51 ESP32/SWDRST: J4.10, JP5.1 (A), R5.1, U2.52 (~RESET), U3.6 (IO3)
/SAMD51 ESP32/VCP_A: C2.2, DRV1.12 (VCP)
/SAMD51 ESP32/VCP_B: C13.2, DRV2.12 (VCP)
GND: C1.1, C3.1, C5.1, C7.2, C8.1, C9.1, C10.1, C11.1, C12.2, C14.1, C17.1, C18.1, C20.2, C21.1, C26.1, C30.2, C31.1, C32.1, C33.2, C34.2, C35.2, C37.2, C38.2, D1.1 (K), D2.1 (K), D6.1 (K), DRV1.9 (PGND), DRV1.15 (GND), DRV1.17 (EP), DRV2.9 (PGND), DRV2.15 (GND), DRV2.17 (EP), FPC2.22, FPC2.23, FPC2.24, J1.1, J2.3, J3.3, J4.3, J4.5, J4.9, JP5.2 (B), R1.2, R3.1, R8.2, R14.1, R15.2, R16.1, R25.2, R26.2, R62.1, R65.1, SW1.C1 (NO_1), SW1.D1 (NO_2), TP2.1 (1_1), TP8.1 (1_1), U2.7 (GNDANA), U2.22 (GND), U2.33 (GND), U2.47 (GND), U2.54 (GND), U3.1 (GND_1), U3.2 (GND_2), U3.11 (GND_3), U3.14 (GND_4), U3.36 (GND_5), U3.37 (GND_6), U3.38 (GND_7), U3.39 (GND_8), U3.40 (GND_9), U3.41 (GND_10), U3.42 (GND_11), U3.43 (GND_12), U3.44 (GND_13), U3.45 (GND_14), U3.46 (GND_15), U3.47 (GND_16), U3.48 (GND_17), U3.49 (GND_18), U3.50 (GND_19), U3.51 (GND_20), U3.52 (GND_21), U3.53 (GND_22), U3.54 (GND_23), U3.55 (GND_24), U3.56 (GND_25), U3.57 (GND_26), U3.58 (GND_27), U3.59 (GND_28), U3.60 (GND_29), U3.61 (GND_30), U4.1 (GND); also elsewhere on the board
unnamed: D6.2 (A), R58.2
unnamed: DRV1.7 (IMODE), R15.1
unnamed: DRV2.7 (IMODE), R25.1
unnamed 106: C1.2, C5.2, U2.53 (VDDCORE); also elsewhere on the board
unnamed: R6.2, R21.2, U3.30 (RXD0)
unnamed: R59.1, U3.31 (TXD0)
unnamed: C36.1, U4.6 (BOOT)
unnamed: R62.2, R64.2, U4.5 (EN)
unnamed: C39.2, R57.1, R65.2, U4.4 (FB)
unnamed: C36.2, L2.1, U4.2 (SW)
VBAT: C2.1, C3.2, C13.1, C14.2, C17.2, C26.2, C31.2, C32.2, C34.1, C35.1, DRV1.11 (VM), DRV2.11 (VM), J1.2, R13.2, R64.1, TP6.1 (1_1), U4.3 (VIN)
VCCANA: C7.1, C30.1, FB1.2, U2.8 (VDDANA); also elsewhere on the board

Notes on the sheet:
TCC1
HTSSOP-16 3.5A Peak 5.00 mm × 4.40 mm
ESP32-C3-MINI-1
ADC0
SENSOR ARRAY CONNECTOR
SENSOR x16
UVLO Start = 6.97V UVLO Stop = 6.00V
MOT_B
TX Peak 350mA @ 20dBm transmission
DRV8876 DRIVERS
STRAPPING PINS GPIO2 GPIO8 GPIO9
Module (PCB Antenna) Dimensions (mm): 13.2 × 16.6 × 2.4 Flash Memory: 4MB
PWM Control Mode (PMODE = Logic High) PH/EN Control Mode (PMODE = Logic Low)
TQFP-64 Dimensions (mm): 12 × 12 × 1.2 Program Memory: 512KB Data Memory: 192KB
- What footprint for SWD connection circuit? OK - Problem with duplicate footprint for same designator
STATUS LEDs
SAMD51 SWD PROGRAMMING
ADC1
one for each power pair on MCU.
ATSAMD51J19A
MOT_A
I_{trip} = VREF / (R_{IPROPI} / 1000)
I_{trip} should be taken close to Stall Current for most accurate reads.
CHECKLIST
ESP32 UART PROGRAMMING
USART

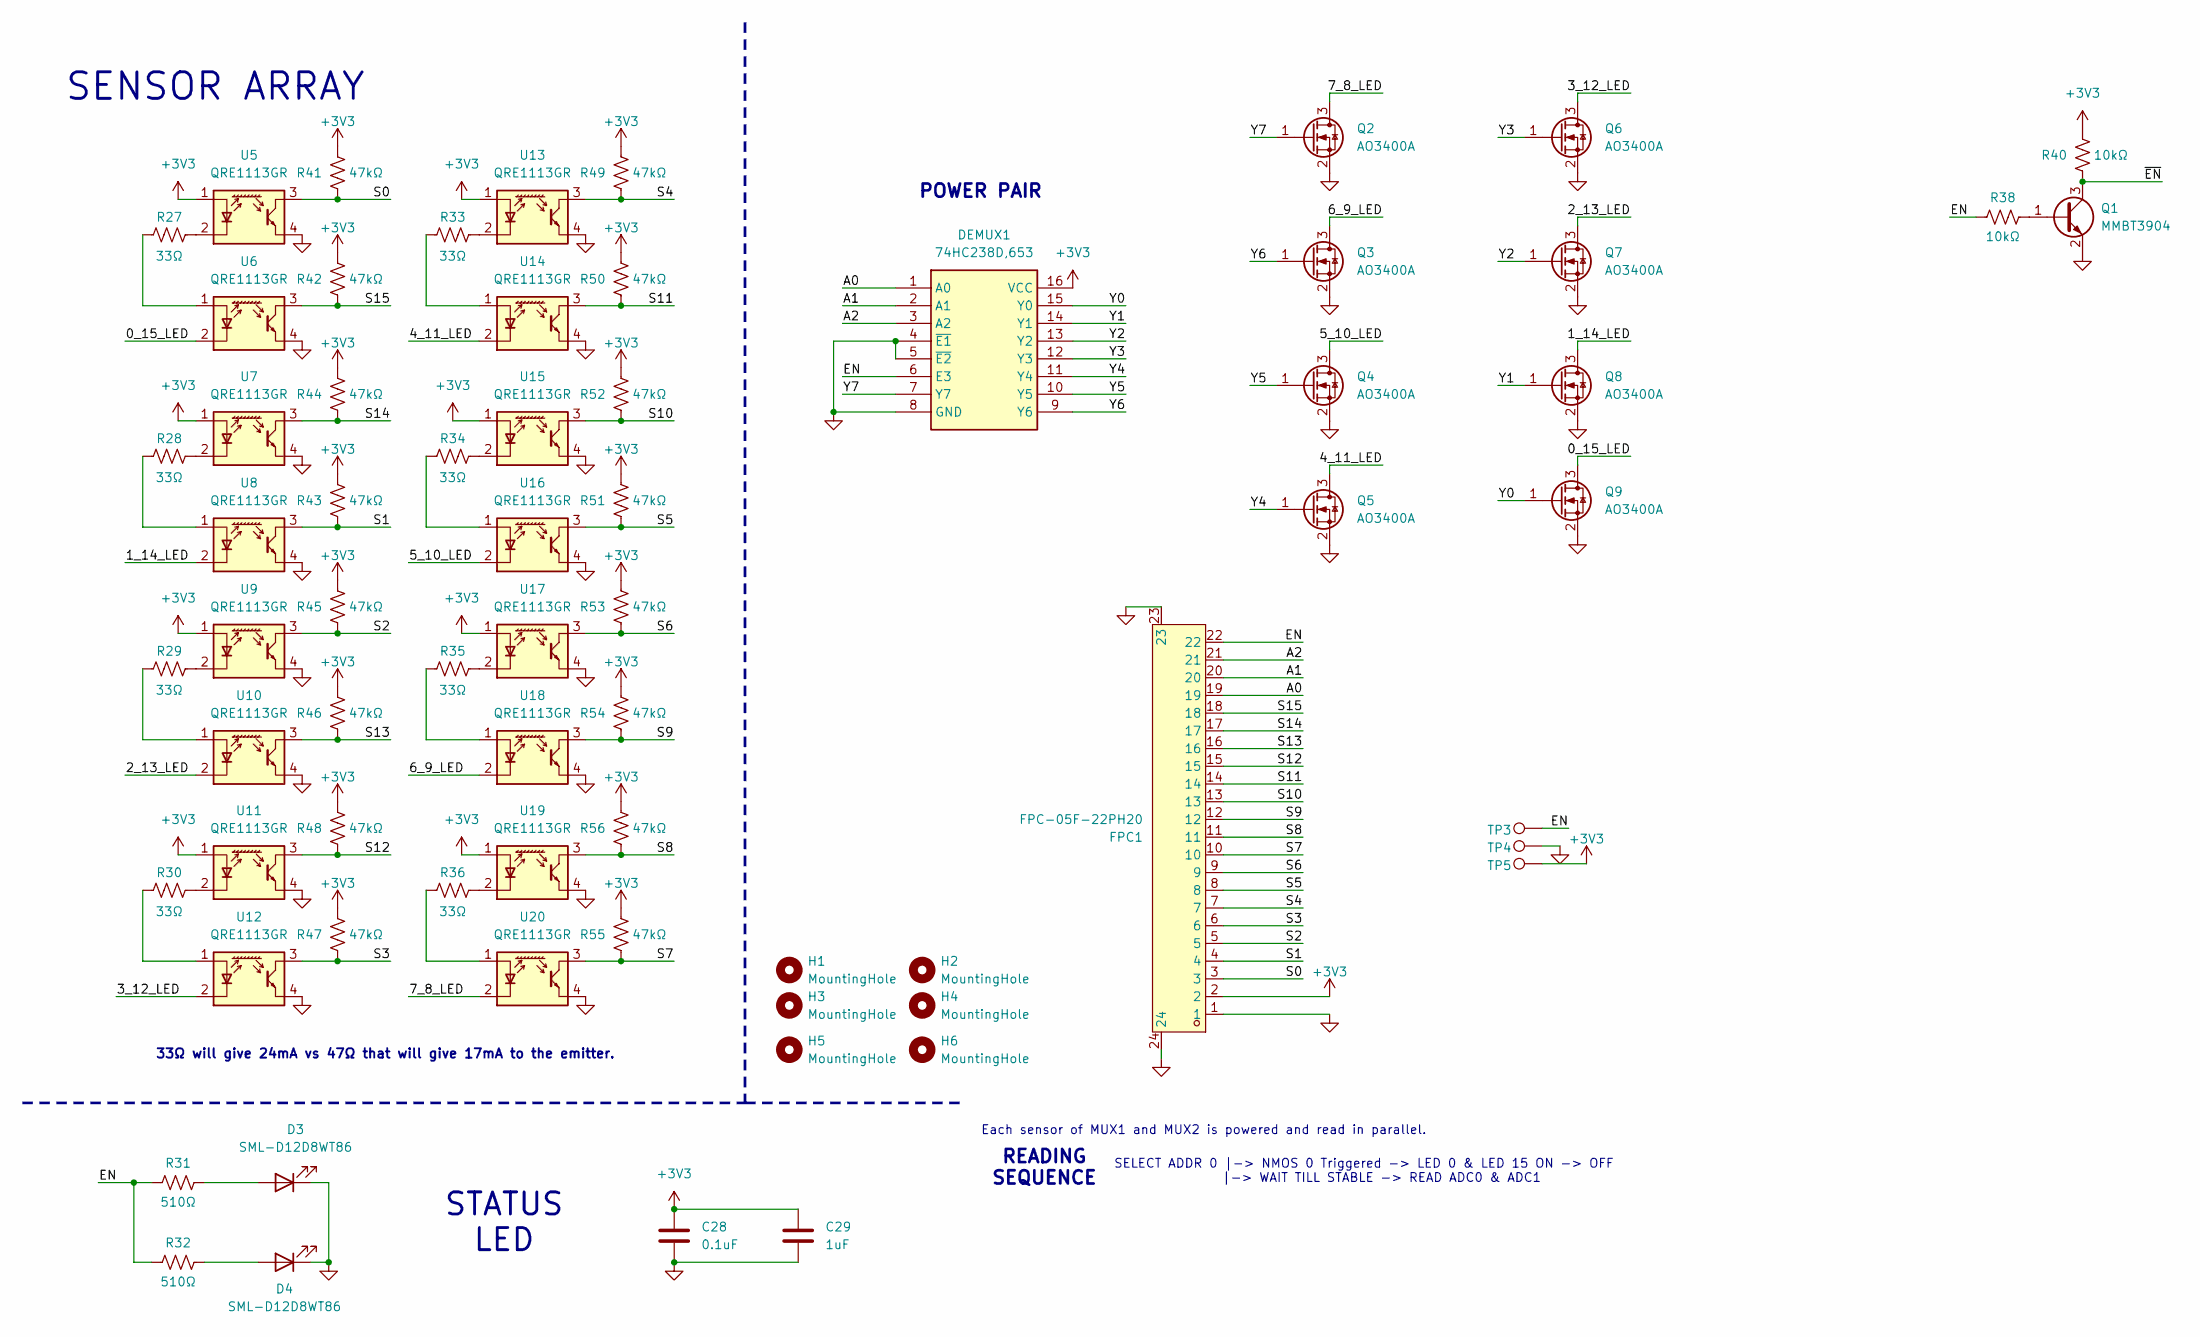
[picture p26: schematic SENSOR_ARRAY.kicad_sch, SAVITAR Version 2]

Parts:
C28: 0.1uF; C_0402_1005Metric_Pad0.74x0.62mm_HandSolder
C29: 1uF; C_0402_1005Metric_Pad0.74x0.62mm_HandSolder
D3, D4: SML-D12D8WT86; LED_0603_1608Metric_Pad1.05x0.95mm_HandSolder
DEMUX1: 74HC238D,653; 74HC238D653; Manufacturer_Part_Number 74HC238D,653; Mouser Part Number 771-74HC238D-T
FPC1: FPC-05F-22PH20; FPC-SMD_22P-P0.50_FPC-05F-22PH20; MPN FPC-05F-22PH20; LCSC Part C2856804
H1, H2, H3, H4: MountingHole; MountingHole_2.2mm_M2_DIN965_Pad
H5, H6: MountingHole; MountingHole_3.2mm_M3
Q1: MMBT3904; SOT-23
Q2, Q3, Q4, Q5, Q6, Q7, Q8, Q9: AO3400A; SOT-23
R27, R28, R29, R30, R33, R34, R35, R36: 33Ω; R_0402_1005Metric_Pad0.72x0.64mm_HandSolder
R31, R32: 510Ω; R_0402_1005Metric_Pad0.72x0.64mm_HandSolder
R38, R40: 10kΩ; R_0402_1005Metric
R41, R42, R43, R44, R45, R46, R47, R48, R49, R50, R51, R52, R53, R54, R55, R56: 47kΩ; R_0402_1005Metric_Pad0.72x0.64mm_HandSolder
TP3, TP4, TP5: TestPoint; TestPoint_Pad_D1.5mm
U5, U6, U7, U8, U9, U10, U11, U12, U13, U14, U15, U16, U17, U18, U19, U20: QRE1113GR; OnSemi_CASE100CY

Connections:
+3V3: C28.1, C29.1, DEMUX1.16 (VCC), FPC1.2, R40.2, R41.2, R42.2, R43.2, R44.2, R45.2, R46.2, R47.2, R48.2, R49.2, R50.2, R51.2, R52.2, R53.2, R54.2, R55.2, R56.2, TP5.1 (1_1), U5.1 (A), U7.1 (A), U9.1 (A), U11.1 (A), U13.1 (A), U15.1 (A), U17.1 (A), U19.1 (A); also elsewhere on the board
/SENSOR ARRAY/0_15_LED: Q9.3 (D), U6.2 (K)
/SENSOR ARRAY/1_14_LED: Q8.3 (D), U8.2 (K)
/SENSOR ARRAY/2_13_LED: Q7.3 (D), U10.2 (K)
/SENSOR ARRAY/3_12_LED: Q6.3 (D), U12.2 (K)
/SENSOR ARRAY/4_11_LED: Q5.3 (D), U14.2 (K)
/SENSOR ARRAY/5_10_LED: Q4.3 (D), U16.2 (K)
/SENSOR ARRAY/6_9_LED: Q3.3 (D), U18.2 (K)
/SENSOR ARRAY/7_8_LED: Q2.3 (D), U20.2 (K)
/SENSOR ARRAY/A0: DEMUX1.1 (A0), FPC1.19
/SENSOR ARRAY/A1: DEMUX1.2 (A1), FPC1.20
/SENSOR ARRAY/A2: DEMUX1.3 (A2), FPC1.21
/SENSOR ARRAY/EN: DEMUX1.6 (E3), FPC1.22, R31.1, R32.1, R38.1, TP3.1 (1_1)
/SENSOR ARRAY/S0: FPC1.3, R41.1, U5.3
/SENSOR ARRAY/S1: FPC1.4, R43.1, U8.3
/SENSOR ARRAY/S2: FPC1.5, R45.1, U9.3
/SENSOR ARRAY/S3: FPC1.6, R47.1, U12.3
/SENSOR ARRAY/S4: FPC1.7, R49.1, U13.3
/SENSOR ARRAY/S5: FPC1.8, R51.1, U16.3
/SENSOR ARRAY/S6: FPC1.9, R53.1, U17.3
/SENSOR ARRAY/S7: FPC1.10, R55.1, U20.3
/SENSOR ARRAY/S8: FPC1.11, R56.1, U19.3
/SENSOR ARRAY/S9: FPC1.12, R54.1, U18.3
/SENSOR ARRAY/S10: FPC1.13, R52.1, U15.3
/SENSOR ARRAY/S11: FPC1.14, R50.1, U14.3
/SENSOR ARRAY/S12: FPC1.15, R48.1, U11.3
/SENSOR ARRAY/S13: FPC1.16, R46.1, U10.3
/SENSOR ARRAY/S14: FPC1.17, R44.1, U7.3
/SENSOR ARRAY/S15: FPC1.18, R42.1, U6.3
/SENSOR ARRAY/Y0: DEMUX1.15 (Y0), Q9.1 (G)
/SENSOR ARRAY/Y1: DEMUX1.14 (Y1), Q8.1 (G)
/SENSOR ARRAY/Y2: DEMUX1.13 (Y2), Q7.1 (G)
/SENSOR ARRAY/Y3: DEMUX1.12 (Y3), Q6.1 (G)
/SENSOR ARRAY/Y4: DEMUX1.11 (Y4), Q5.1 (G)
/SENSOR ARRAY/Y5: DEMUX1.10 (Y5), Q4.1 (G)
/SENSOR ARRAY/Y6: DEMUX1.9 (Y6), Q3.1 (G)
/SENSOR ARRAY/Y7: DEMUX1.7 (Y7), Q2.1 (G)
GND: C28.2, C29.2, D3.1 (K), D4.1 (K), DEMUX1.4 (~E1), DEMUX1.5 (~E2), DEMUX1.8 (GND), FPC1.1, FPC1.23, FPC1.24, Q1.2 (E), Q2.2 (S), Q3.2 (S), Q4.2 (S), Q5.2 (S), Q6.2 (S), Q7.2 (S), Q8.2 (S), Q9.2 (S), TP4.1 (1_1), U5.4, U6.4, U7.4, U8.4, U9.4, U10.4, U11.4, U12.4, U13.4, U14.4, U15.4, U16.4, U17.4, U18.4, U19.4, U20.4; also elsewhere on the board
unnamed: D3.2 (A), R31.2
unnamed: D4.2 (A), R32.2
unnamed: Q1.1 (B), R38.2
unnamed: Q1.3 (C), R40.1
unnamed: R27.2, U5.2 (K)
unnamed: R27.1, U6.1 (A)
unnamed: R28.2, U7.2 (K)
unnamed: R28.1, U8.1 (A)
unnamed: R29.2, U9.2 (K)
unnamed: R29.1, U10.1 (A)
unnamed: R30.2, U11.2 (K)
unnamed: R30.1, U12.1 (A)
unnamed: R33.2, U13.2 (K)
unnamed: R33.1, U14.1 (A)
unnamed: R34.2, U15.2 (K)
unnamed: R34.1, U16.1 (A)
unnamed: R35.2, U17.2 (K)
unnamed: R35.1, U18.1 (A)
unnamed: R36.2, U19.2 (K)
unnamed: R36.1, U20.1 (A)

Notes on the sheet:
SELECT ADDR 0 |-> NMOS 0 Triggered -> LED 0 & LED 15 ON -> OFF |-> WAIT TILL STABLE -> READ ADC0 & ADC1
Each sensor of MUX1 and MUX2 is powered and read in parallel.
STATUS LED
POWER PAIR
READING SEQUENCE
SENSOR ARRAY
33Ω will give 24mA vs 47Ω that will give 17mA to the emitter.

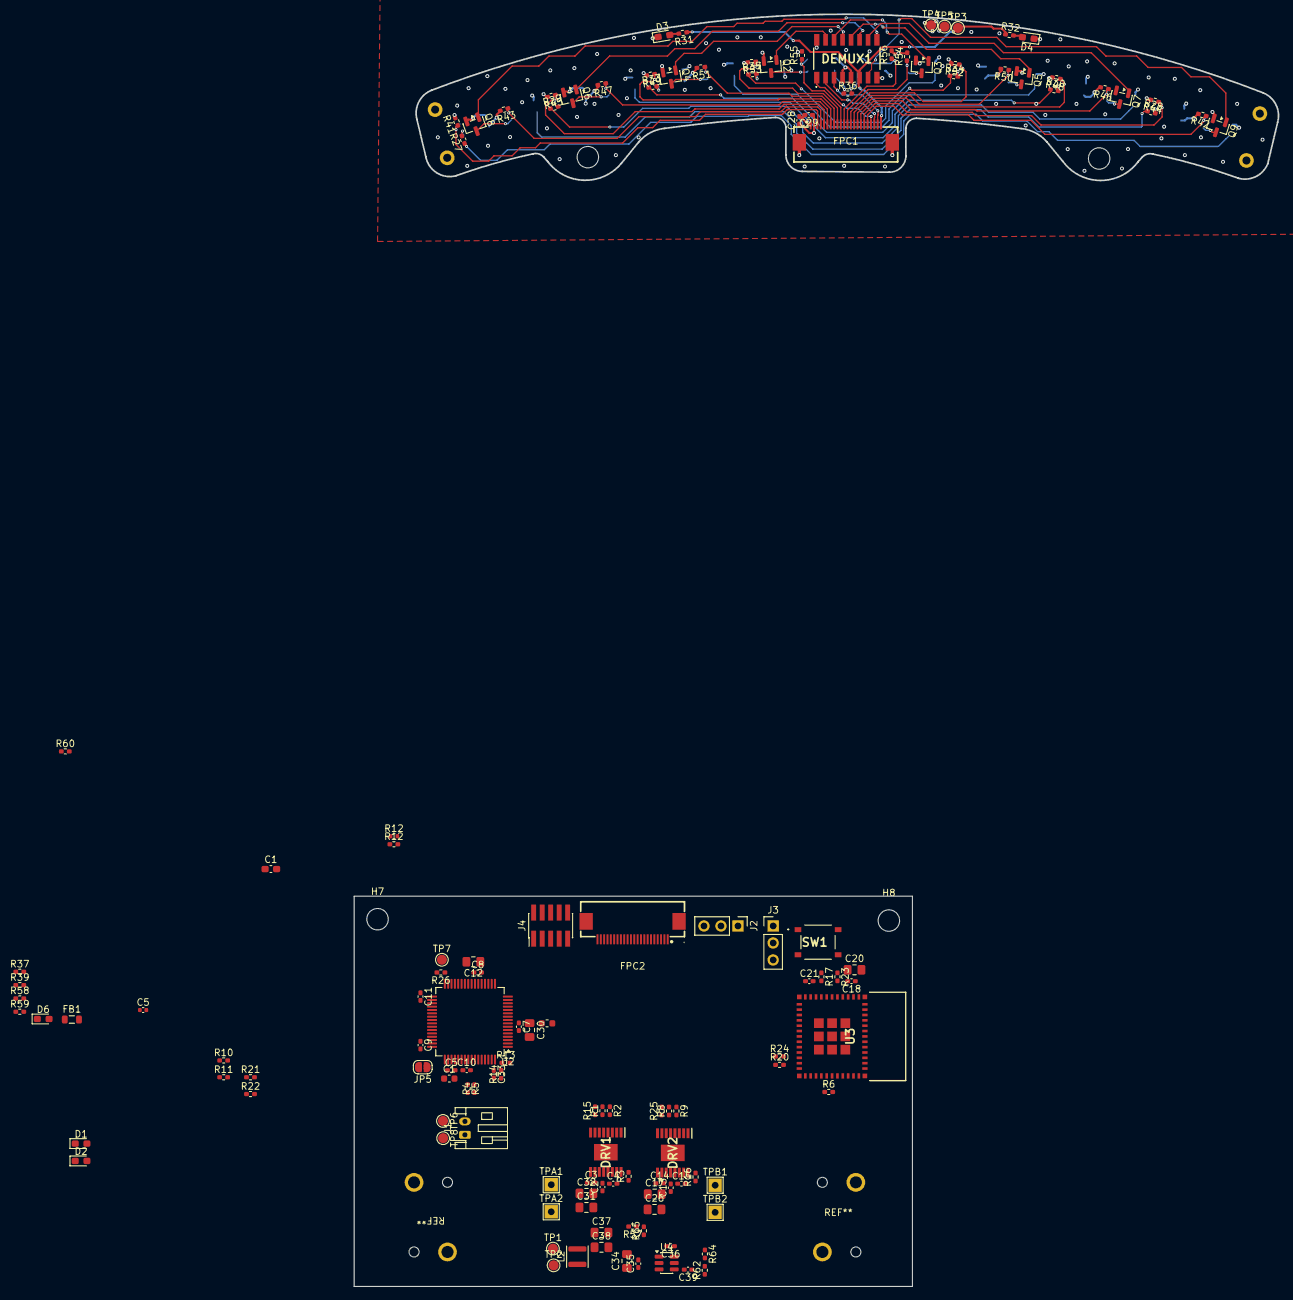
[picture p27: board SAVITAR_V2.kicad_pcb from above]

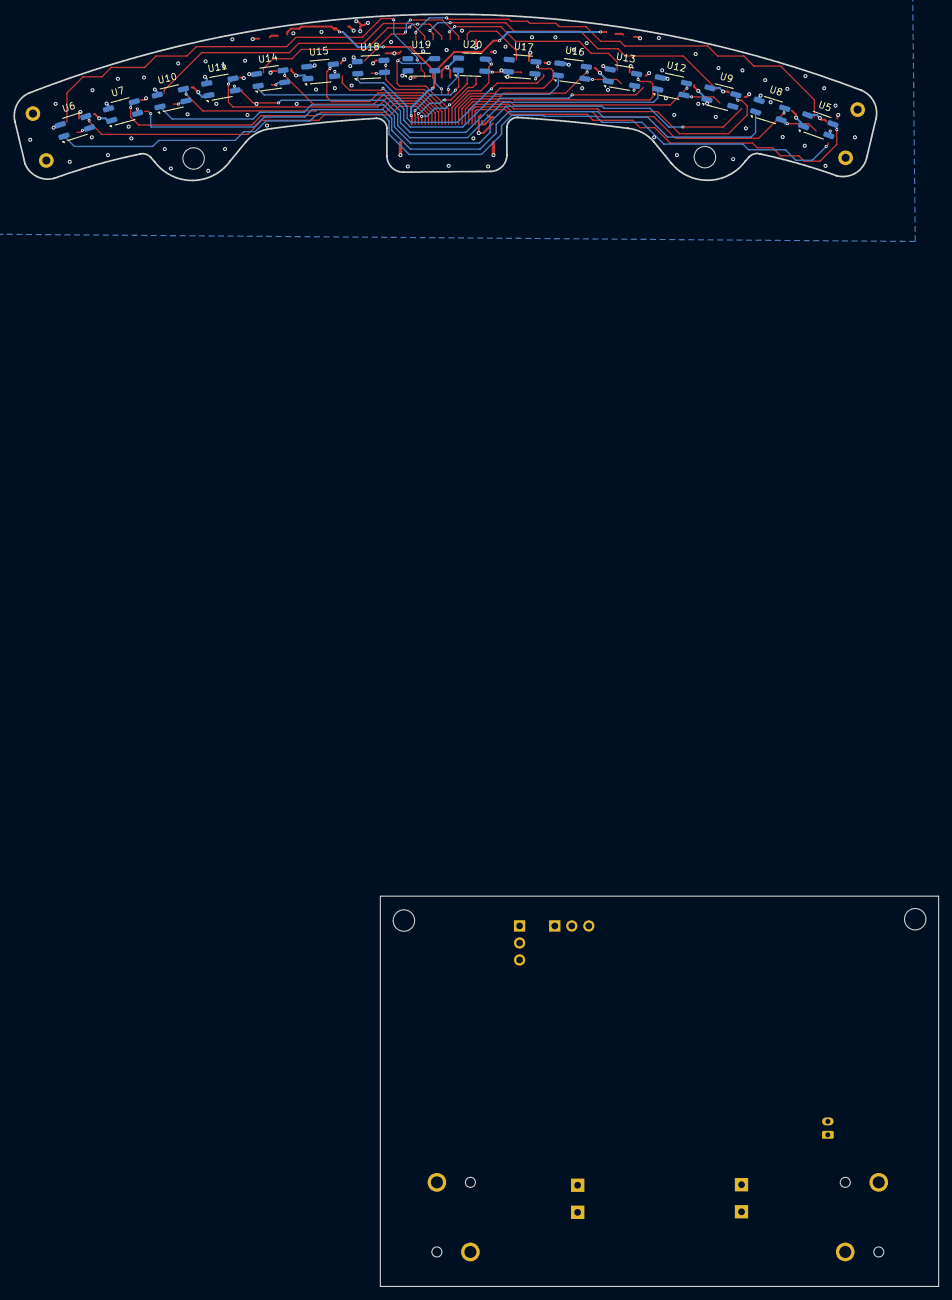
[picture p28: board SAVITAR_V2.kicad_pcb from below]

Board: 4 copper layers, 138.1 x 190.0 mm, 158 parts (16 on the bottom side), 129 nets.

Other parts of the board:
C1#2: 4.7uF (X7R); C_0603_1608Metric
C5#2: 1uF (X7R); C_0402_1005Metric
FB1#2: 380mΩ 500mA; L_0603_1608Metric
R12#2: 100Ω; R_0402_1005Metric

Their connections:
/SAMD51 ESP32/GCLK/ IO[1]: R12#2.1; also elsewhere on the board
/SAMD51 ESP32/IO10: R12#2.2; also elsewhere on the board
GND: C1#2.1, C5#2.2; also elsewhere on the board
unnamed 106: C1#2.2, C5#2.1; also elsewhere on the board
VCCANA: FB1#2.2; also elsewhere on the board
