alexandru-mot/SAVITAR-V2-PCB/(commit log)

2026-05-10 Initial commit.
    [52271-0869.stp, CD4051BM_TR.stp, FH34SRJ-12S-0.5SH_50_.stp, FH34SRJ-8S-0.5SH_50_.stp, SAVITAR_V2.kicad_pcb, SAVITAR_V2.kicad_sch]
2026-05-12 Added Decoder 3x8 (74HC238D) and 8 NMOS array (TBD62083AFNG) for driving the LEDs in pairs of 2 (±40 mA) only when they are read.
    [74HC238D,653.stp, SAVITAR_V2.kicad_sch, TBD62083AFNG_Z,EL_.stp]
2026-05-14 Changed schematic structure. Separated sensor array from PD processing and motor control. Sensor schematic is finished. Moving to MCU wiring. All project symbols and footprints are under SAVITAR name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
    [MCU.kicad_sch, SAVITAR_V2.kicad_sch, SENSOR_ARRAY.kicad_sch]
2026-05-14 Started designing main schematic. Added DRV8833 circuit with 2 motors attached.
    [MCU.kicad_sch]
2026-05-14 Added power regulation using buck DC-DC switching regulator MT2492 and an LDO LD1117S33CTR for clearing ripple.
    [MCU.kicad_sch, MT2492.stp]
2026-05-17 Changed motor driver from DRV8874 to a simpler, small-footprint DRV8837 using the IN1/IN2 interface.
    [DEV-15583.step, DRV8874PWPR.stp, MCU.kicad_sch, SAVITAR_BOM.xlsx, SAVITAR_V2.kicad_sch, SENSOR_ARRAY.kicad_sch]
2026-05-19 Added ESP32-C3-MINI-1 circuit for the PD control over AP STA. Added comments and read sequence explanation. The schematic is finished, please add tag.
    [ESP32-C3-MINI-1-H4X.stp, MCU.kicad_sch, SAVITAR_V2.kicad_sch, SENSOR_ARRAY.kicad_sch]
2026-05-20 Added dedicated Current Sensing IC INA240. Changed Buck output from 3.8V (edge of Teensy's LDO supply voltage) to 5V.
    [INA240A1DR.stp, MCU.kicad_sch, SAVITAR_V2 BOM.csv, SAVITAR_V2.kicad_pcb, SENSOR_ARRAY.kicad_sch]
2026-05-21 Added decoupling for sensor board. Changed the relatively old CD4051BM with over 400 ohm to 74HC4051. Added for the first time hierarchical label to connect the FFC pins across schematics.
    [MCU.kicad_sch, SAVITAR_V2 BOM.csv, SAVITAR_V2.kicad_pcb, SAVITAR_V2.kicad_sch, SENSOR_ARRAY.kicad_sch]
2026-05-23 Added 3D models to third party footprints. Final Teensy version, switching to SAMD51 custom setup. Please add tag.
    [ESP32-C3-MINI-1-N4.stp, FH34SRJ-8S-0.5SH_50_.step, FH34SRJ-8S-0.5SH_99_.stp, MCU.kicad_sch, SAVITAR_V2.kicad_pcb, SAVITAR_V2.kicad_sch, SENSOR_ARRAY.kicad_sch]
2026-05-26 Add main board: power tree, USB-C, ESP32-C3, dual DRV8874 motor drive
    Power:
    - Add 100nF per-pin decoupling + 22uF bulk on SAMD51 supplies
    - Add 120R@100MHz/2A ferrite bead on VDDANA for ADC supply isolation
    - Change buck output 5V -> 3.8V; inductor 22uH -> 6.8uH; FB R7 13.7k -> 18.7k
    - Add 22pF feedforward cap across buck FB top resistor
    - Keep TLV75733 LDO (fed from 3.8V) for 3.3V rail; dissipation now ~0.15W
    USB:
    - Add USBLC6-2SC6 ESD protection on D+/D-/VBUS
    - Isolate VBUS from power path (sense-only); board powered from battery
    ESP32-C3-MINI-1:
    - Change 3V3 bulk 1x22uF -> 2x22uF for 350mA TX bursts
    - 10k EN + 1uF (10ms POR), boot/reset buttons to GND
    - UART0 to SAMD51 for data; native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
    [MCU.kicad_sch]
2026-05-28 Made passives smaller from 0603 to 0402 because I will solder them with hot air gun anyway. Started positioning SAMD51 bypass caps.
    [FSUSB42MUX.stp, MCU.kicad_sch, SAVITAR_BOM.xlsx, SAVITAR_LCSC_CART.csv, SAVITAR_V2 BOM.csv, SAVITAR_V2.kicad_pcb, SAVITAR_V2.kicad_sch, SAVITAR_V2_BOM.csv]
2026-07-18 Done cleanup with Claude.
    BOM cross-referenced from LCSC cart and KiCad reference designators, deleted unused libraries, excluding Backups now gitignore.
    [FSUSB42MUX.stp, SAVITAR_LCSC_CART.csv, SAVITAR_V2_BOM.csv, SAVITAR_V2_BOM.xlsx, SAVITAR_V2_BOM_old.csv]
2026-07-18 Added schematic output.
2026-07-26 Removed the following: ESP32-C3 USB path: FSUSB4 mux + slide switch — dropped entirely. Rationale: SAMD51 programming now exclusively via SWD (Segger, no USB needed), telemetry/config now exclusively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
    [MCU.kicad_sch]
2026-07-26 Added Pin Planner
2026-07-30 Add SAMD51 pin planner and LFR torque calculator tools
    Move samd51-pin-planner.html into Tools/ alongside a new
    lfr-torque-calculator.html and its SAMD51A19J.json pin/peripheral
    data source. Also ignore KiCad's transient *.lck files going forward.
    Minor schematic touch-ups: corrected a resistor value typo in
    SENSOR_ARRAY (47Ω, was mislabeled Ω-less) and updated the MCU
    checklist note to reflect open questions (peripheral mux, current
    sensing) instead of a stale done item.
    [MCU.kicad_sch, SENSOR_ARRAY.kicad_sch]
2026-07-30 Remove INA240 current sensing from motor drive
    Drop both INA240A1DR current-sense amplifiers and their support
    passives from the DRV8874 motor drive circuit, along with the
    associated SENSE_IN/C_SENSE nets and "MOTOR CURRENT SENSING"
    annotation. This was flagged as an open question on the MCU
    checklist; decided to simplify rather than keep it.
    [MCU.kicad_sch]
2026-08-08 Will add info in a later commit
    [MCU.kicad_sch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]
2026-09-06 Assigned Pins on SAMD51 using Pin Planner and PMODE is hardwired to VCC (PWM mode).
    [MCU.kicad_sch, SAVITAR_V2.kicad_pcb]
2026-10-30 Finished routing Sensor array.
2026-11-05 Last update before removing the USB and switching to UART download. ESP32 will program SAMD51 over SWD. DRV8876 will be used. Upcoming reverse polarity protection for battery and deciding on the UART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
2026-11-13 Added rough placement and motor gear for sub-micro planetary motors.
